JeffOlsen-SLAC/LG_Pizza_BPM/doc/rsttiming.jpg

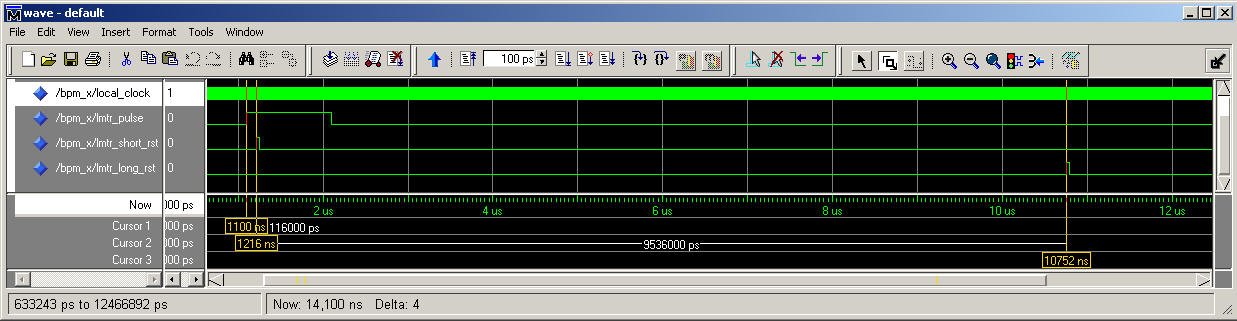
doc/rsttiming.jpg
