JeffOlsen-SLAC/LG_Pizza_BPM/doc/TTLTrig.pdf

## LCLS Digital BPM

Converting the BPM Trigger input from NIM to TTL.

1. Remove transformer T2
2. Jumper pin 6 to 1

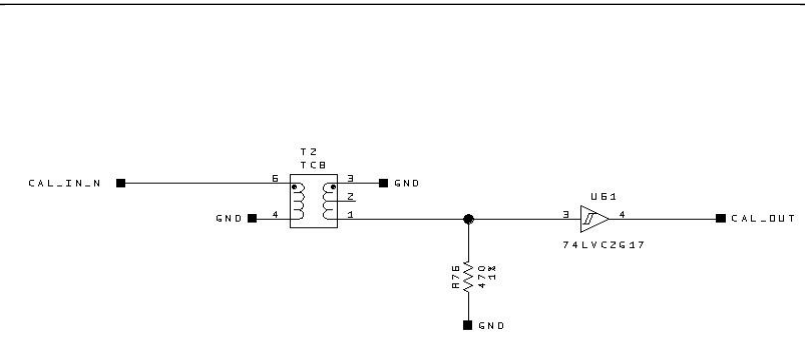
[picture p4: figure]
