JeffOlsen-SLAC/LG_Pizza_BPM/doc/panel1.jpg

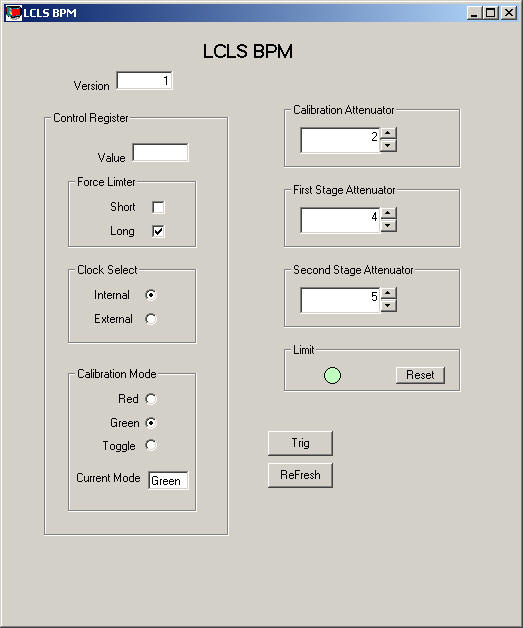
doc/panel1.jpg
