JeffOlsen-SLAC/LG_Pizza_BPM/doc/TTLTrig.jpg

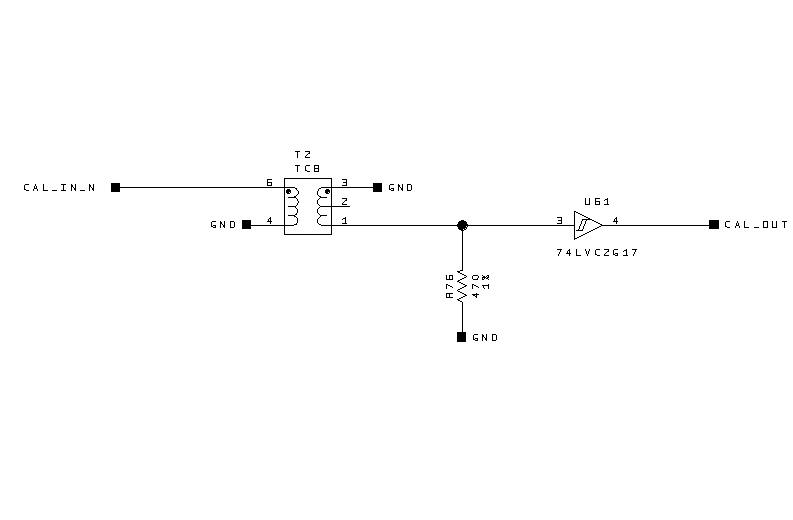
doc/TTLTrig.jpg
