JeffOlsen-SLAC/LG_Pizza_BPM/doc/bpm_digital.xls

# | QTY | REFDES | PART NUMBER | DESCRIPTION
1 | 1 | U6 |  | 74LVC2G17DBVR; PHILLIPS DUAL NON-INVERTING SCHMITT-TRIGGER
2 | 1 | $1I274\$1I151 |  | 2380-5121TG; 3M RIGHT ANGLE HEADER|92F1470; NEWARK PART NUMBER|ONLY 6 PINS USED
3 | 1 | $1I292 |  | 2520-6002UB; 20 PIN HEADER
4 | 1 | $1I46 |  | 5745781-2; AMP DB9 PCB RIGHT ANGLE MOUNT CONNECTOR|42K8778 NEWARK PART NUMBER
5 | 1 | C7 |  | C0805C102K5RAC; KEMET 0.001UF, 0805 CAPACITOR
6 | 4 | $1I38-41 |  | C0805C104K5RAC; KEMET 0.1UF, 0805 CAPACITOR
7 | 20 | C89-108 |  | C0805C104K5RAC; KEMET 0.1UF, 0805 CAPACITOR
8 | 1 | $1I315 |  | CTS; CB3LV-3C-60.0000-T. 60 MHZ OSCILLATOR. 3.3V SMD|CTX285LVCT-ND DIGI-KEY PART
9 | 2 | U4-5 |  | MAX701CSA; MAXIM POWER SUP.
10 | 1 | $1I42 |  | MAX3232ECWE; MAX RS232 TRANSCEIVER
11 | 1 | TP1 |  | MOUSER 151-201 WHITE TEST POINT
12 | 2 | U10,U16 |  | NC7S32M5X; FAIRCHILD 2 INPUT OR GATE
13 | 1 | U7 |  | NC7SZ74K8X; FAIRCHILD TINYLOGIC UHS D FLIP-FLOP
14 | 1 | R15 |  | RK73H2AT51R1; KOA 51.1 OHM 1% 100MW RESISTOR
15 | 2 | R23-24 |  | RK73H2AT68R1F; KOA 68.1 OHM 1% 100MW RESISTOR
16 | 7 | R6-12 |  | RK73H2AT1001F; KOA 1.00K OHM 100MW RESISTOR
17 | 1 | R5 |  | RK73H2AT3010F; KOA 301 OHM 100MW RESISTOR
18 | 1 | R28 |  | RK73H2AT4020F; KOA 402 OHM 1% 100MW RESISTOR
19 | 1 | R27 |  | RK73H2AT4700F; KOA 470 OHM 1% 100MW RESISTOR
20 | 2 | R13-14 |  | RK73H2AT4751F; KOA 4.75K OHM 1% RESISTOR. SM0805
21 | 1 | R22 |  | RK73H2AT6040F; KOA 604 OHM 1% 100MW RESISTOR
22 | 2 | $1I317-318 |  | SMA
23 | 4 | $1I51,$1I108,$1I111,$1I194 |  | SN74ALVC16T245DGG; 16-BIT BIDIRECTIONAL LEVEL TRANSCEIVER
24 | 1 | T2 |  | TC-8; MINI-CIRCUITS RF TRANSFORMER
25 | 1 | U3 |  | XC3S200-5PQ208C; XILINX SPARTAN 3 FPGA
26 | 1 | $1I274\$1I9 |  | XC3S400-5PQ208C; XILINX SPARTAN 3 FPGA
27 | 2 | U8-9 |  | XCF02SVO20C; XILINX PLATFORM FLASH PROM
