JeffOlsen-SLAC/LG_Pizza_BPM/(list of files, cad)

Other CAD files:
xilinx/bpm_x_V3x/work/bpm/_vhdl.psm
