JeffOlsen-SLAC/LG_Pizza_BPM/doc/digital_bpm.pdf

A

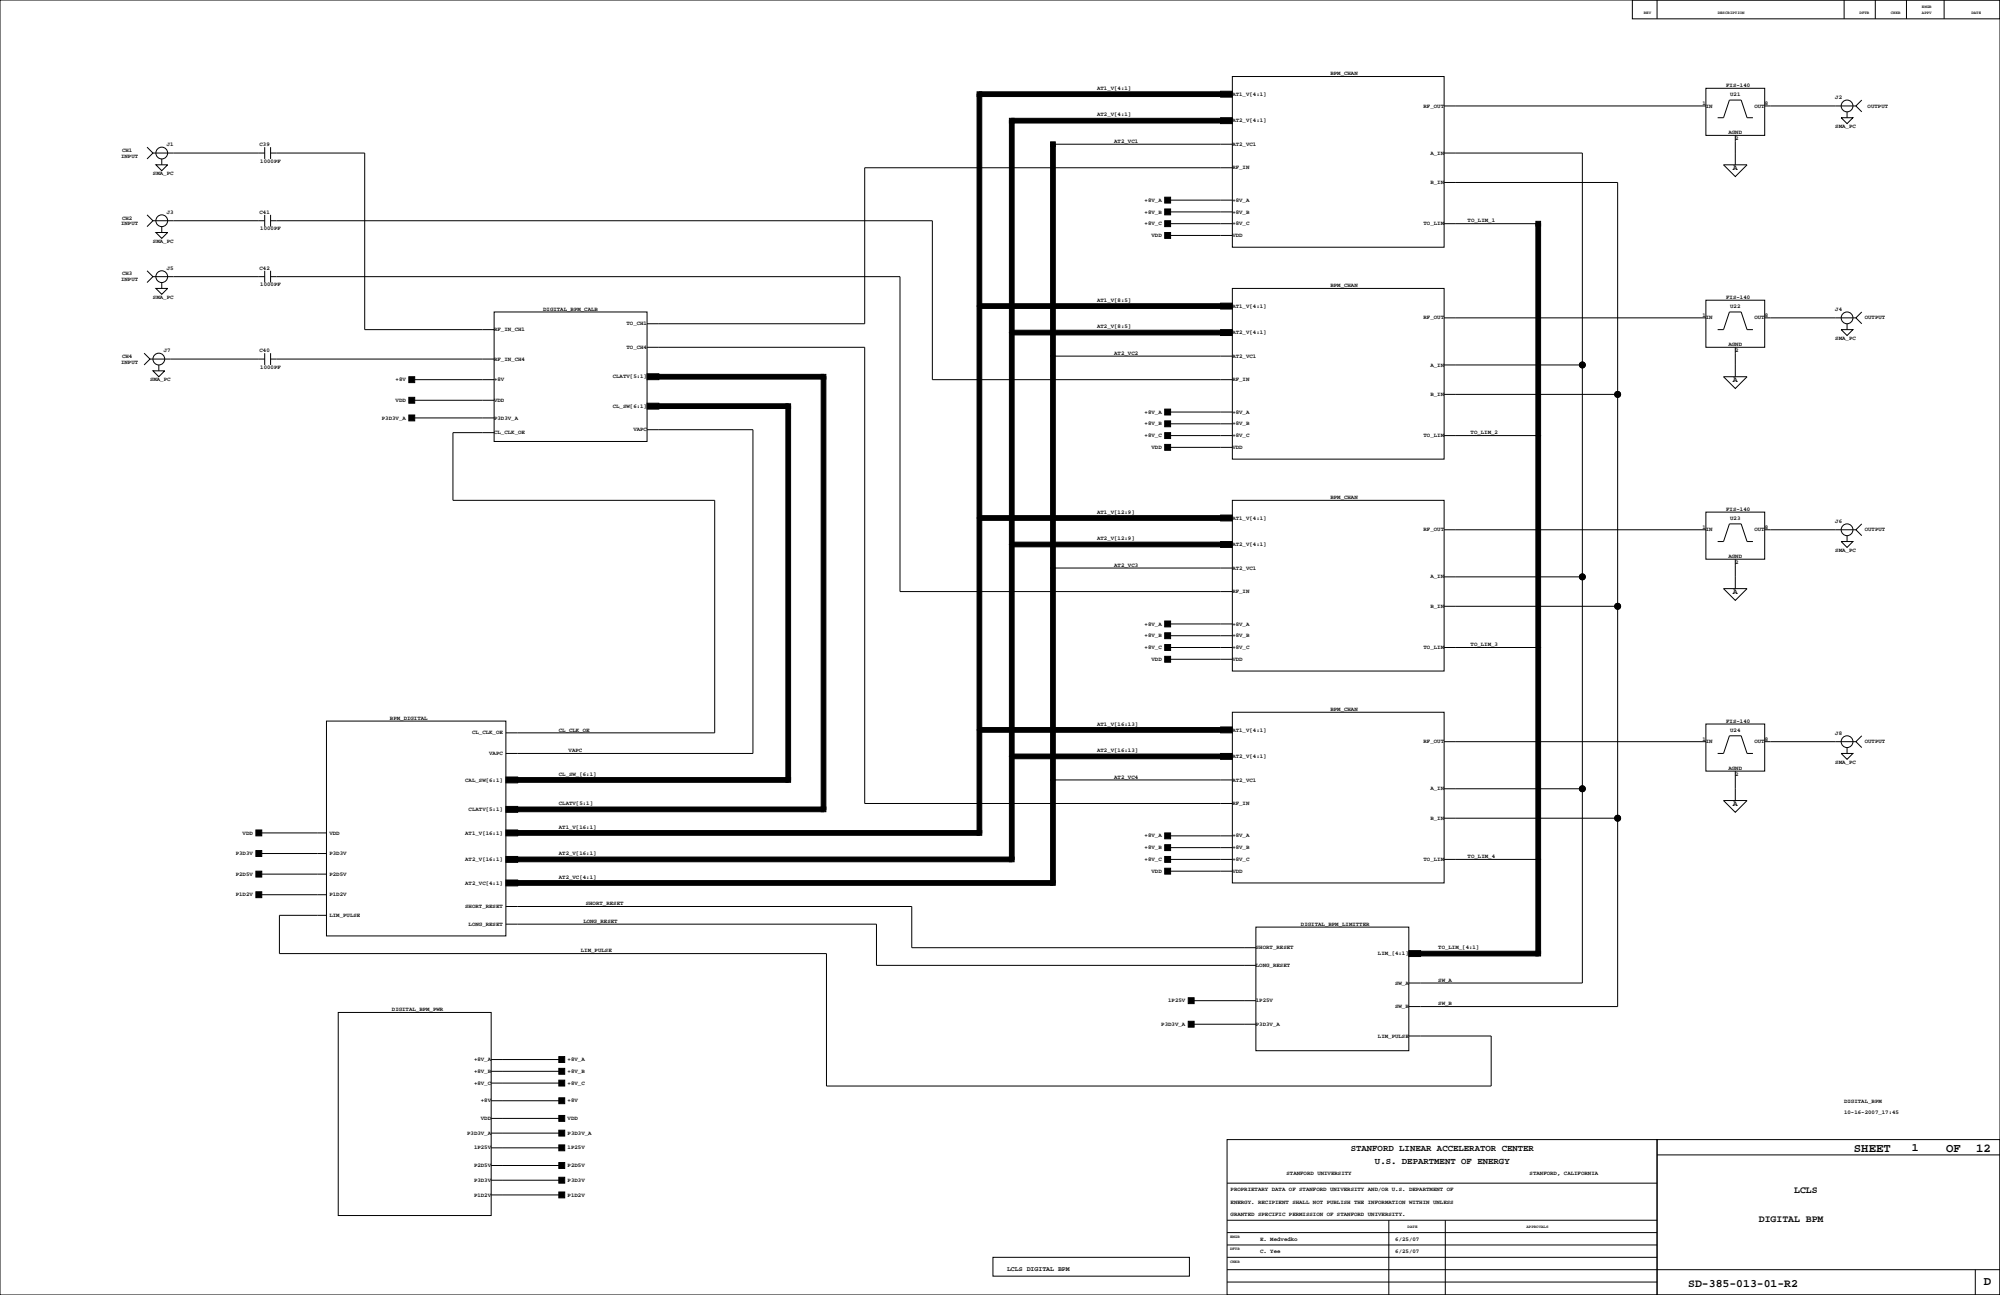
[picture p7: page 1]

STANFORD LINEAR ACCELERATOR CENTER
U.S. DEPARTMENT OF ENERGY

PROPRIETARY DATA OF STANFORD UNIVERSITY AND/OR U.S. DEPARTMENT OF

ENERGY. RECIPIENT SHALL NOT PUBLISH THE INFORMATION WITHIN UNLESS

GRANTED SPECIFIC PERMISSION OF STANFORD UNIVERSITY.

A
A

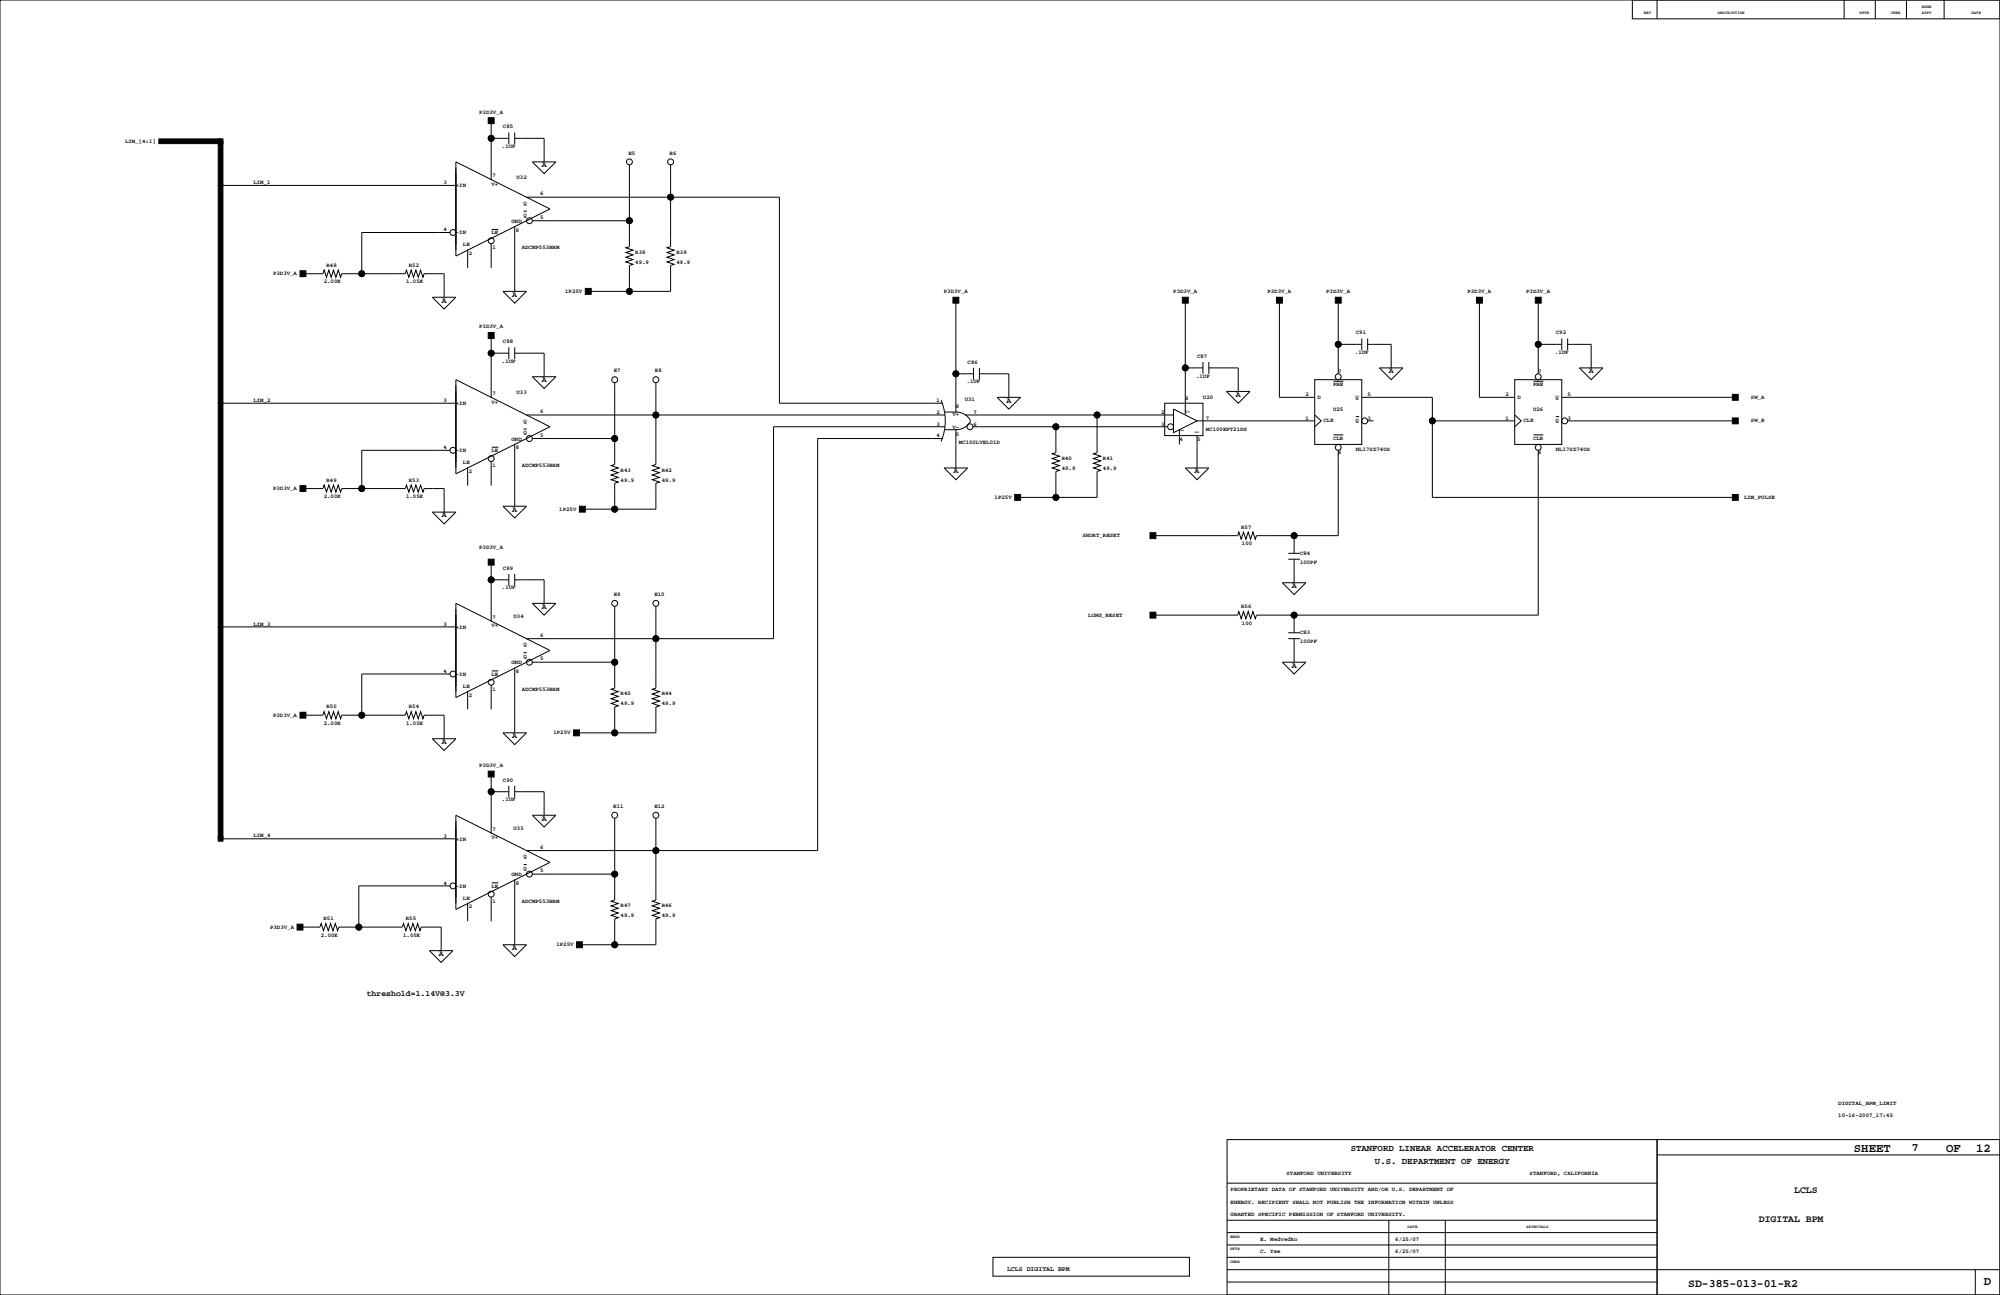
[picture p8: page 2]

STANFORD LINEAR ACCELERATOR CENTER
U.S. DEPARTMENT OF ENERGY

A

A

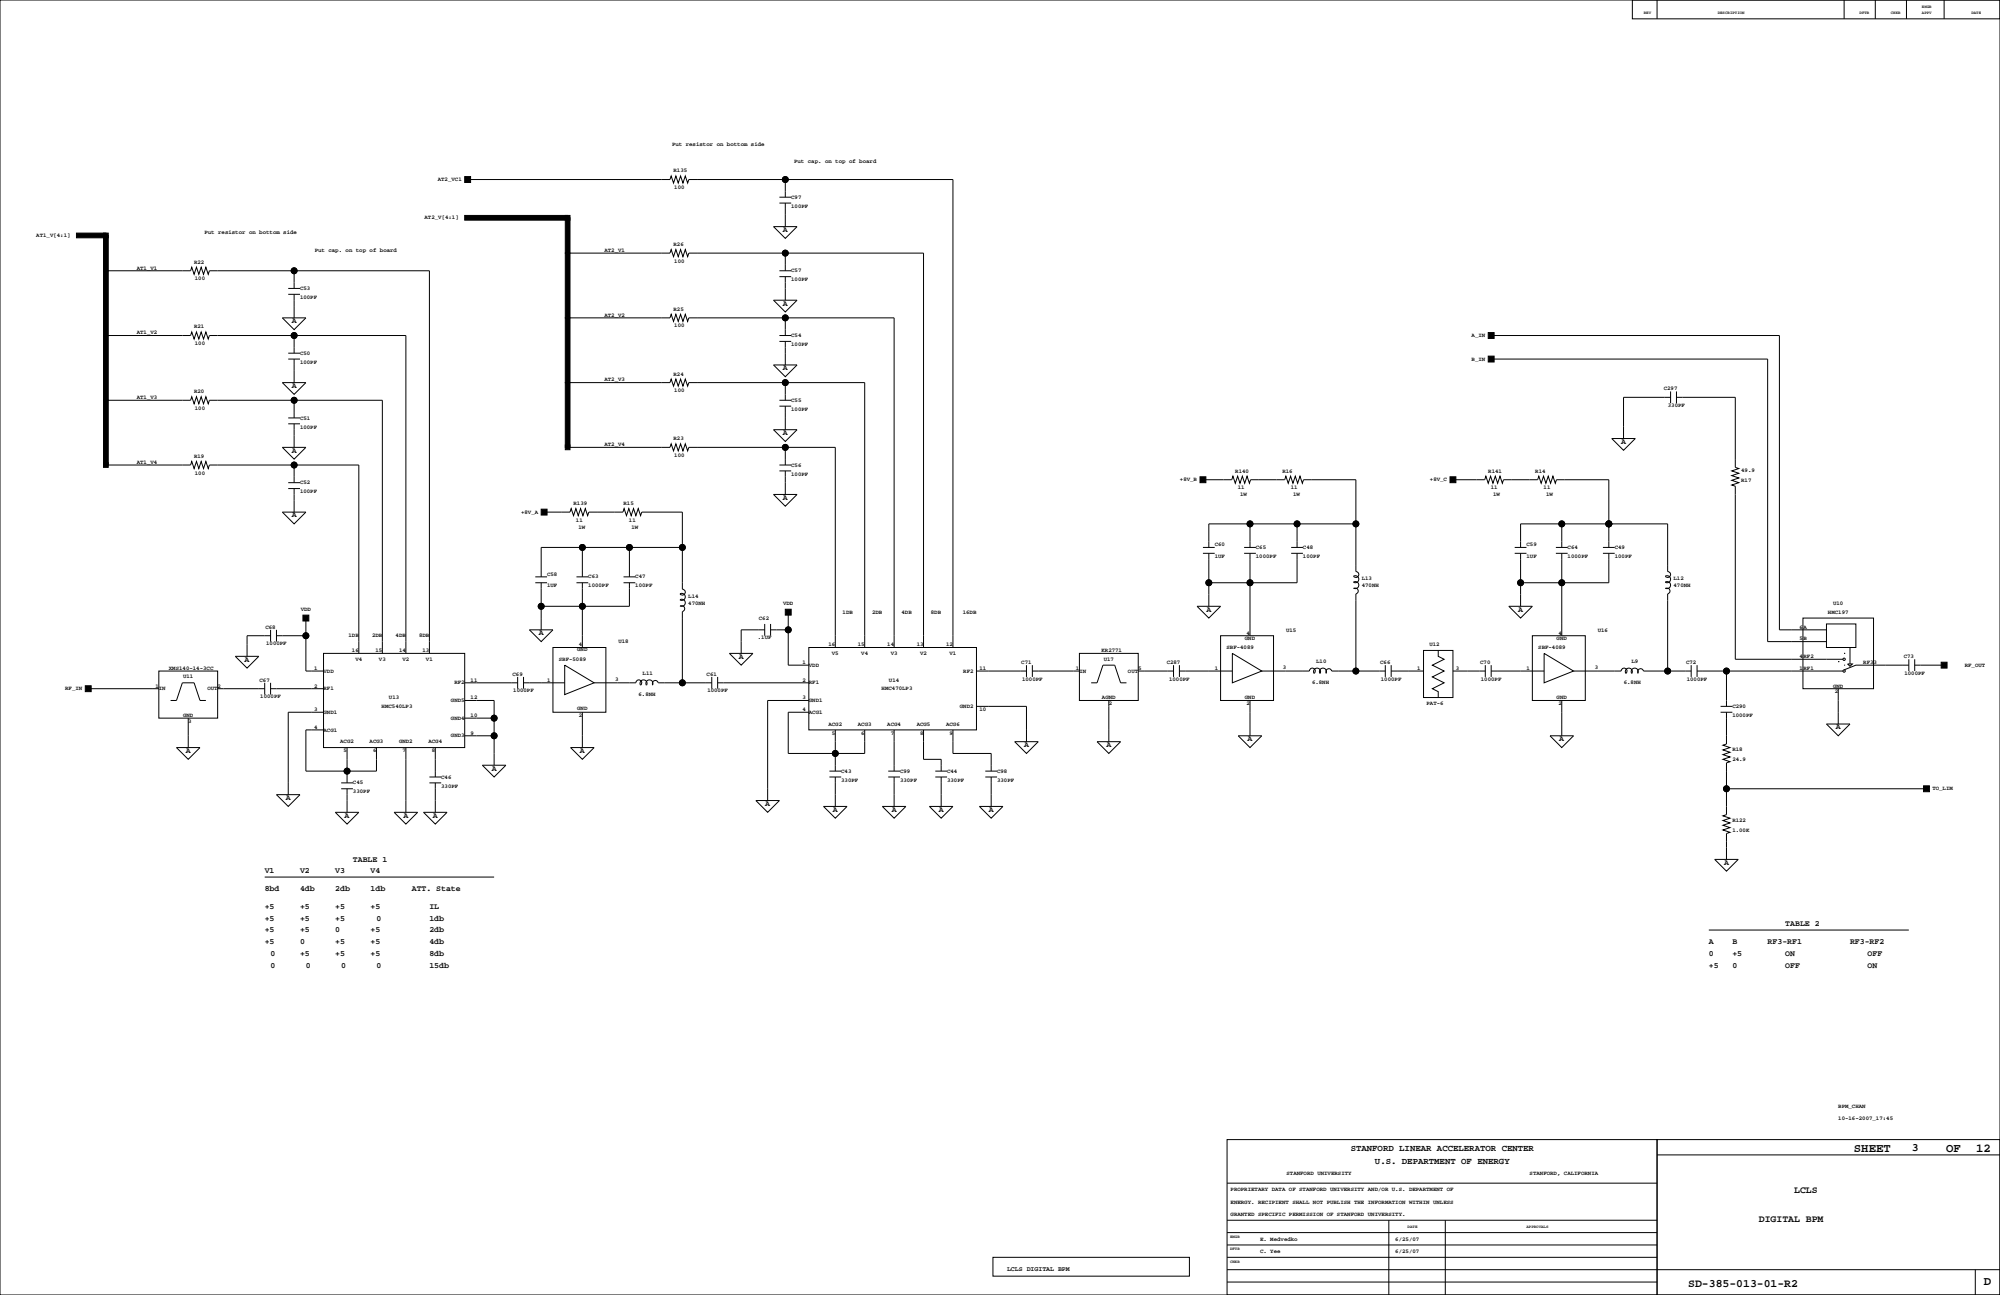
[picture p9: page 3]

Put resistor on bottom side

Put cap. on top of board

STANFORD LINEAR ACCELERATOR CENTER
U.S. DEPARTMENT OF ENERGY

A

A

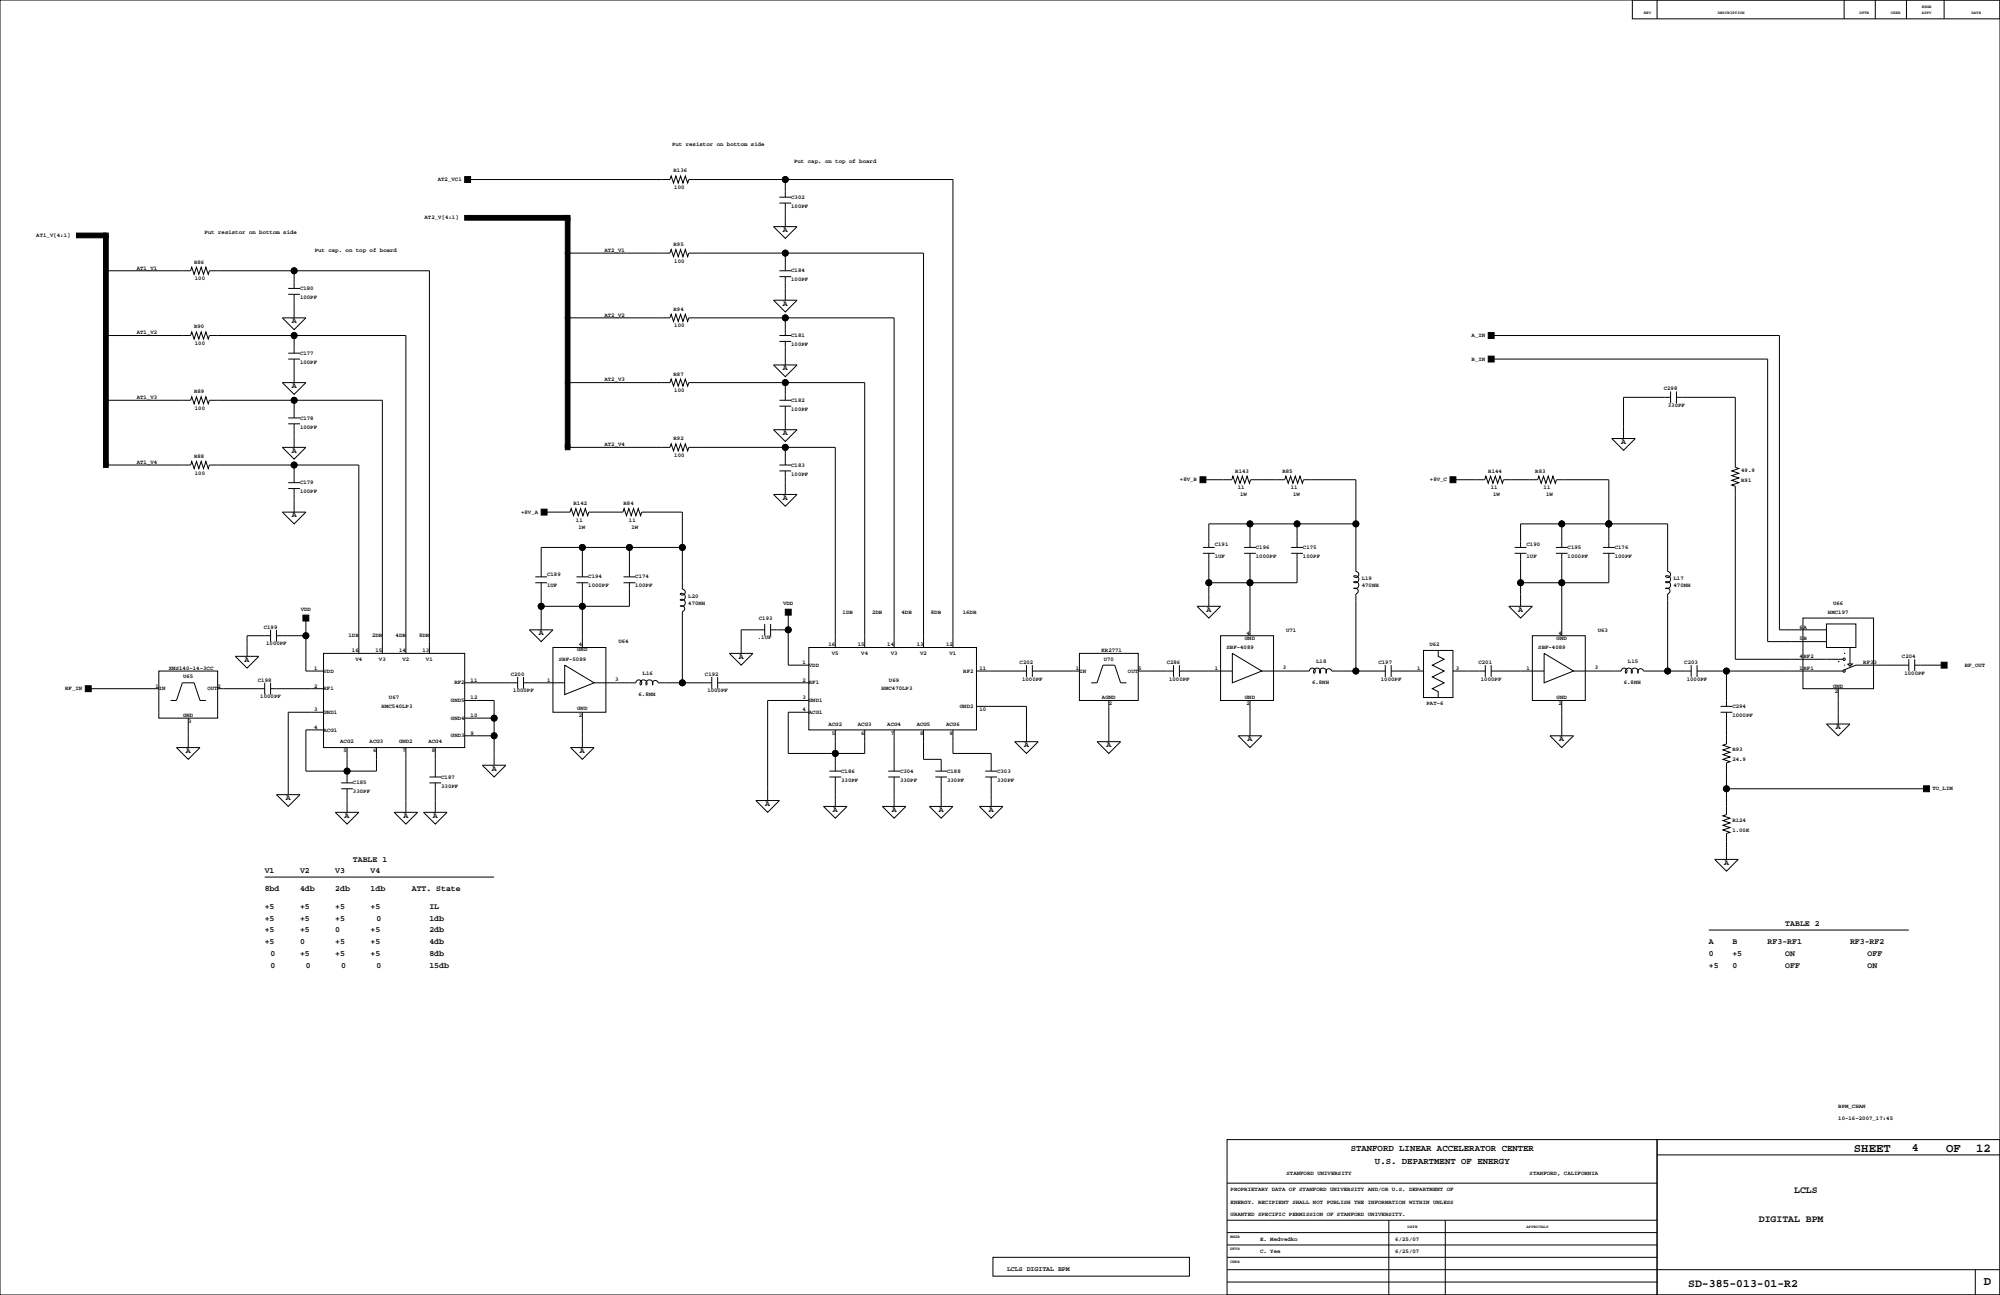
[picture p10: page 4]

Put resistor on bottom side

Put cap. on top of board

STANFORD LINEAR ACCELERATOR CENTER
U.S. DEPARTMENT OF ENERGY

A

A

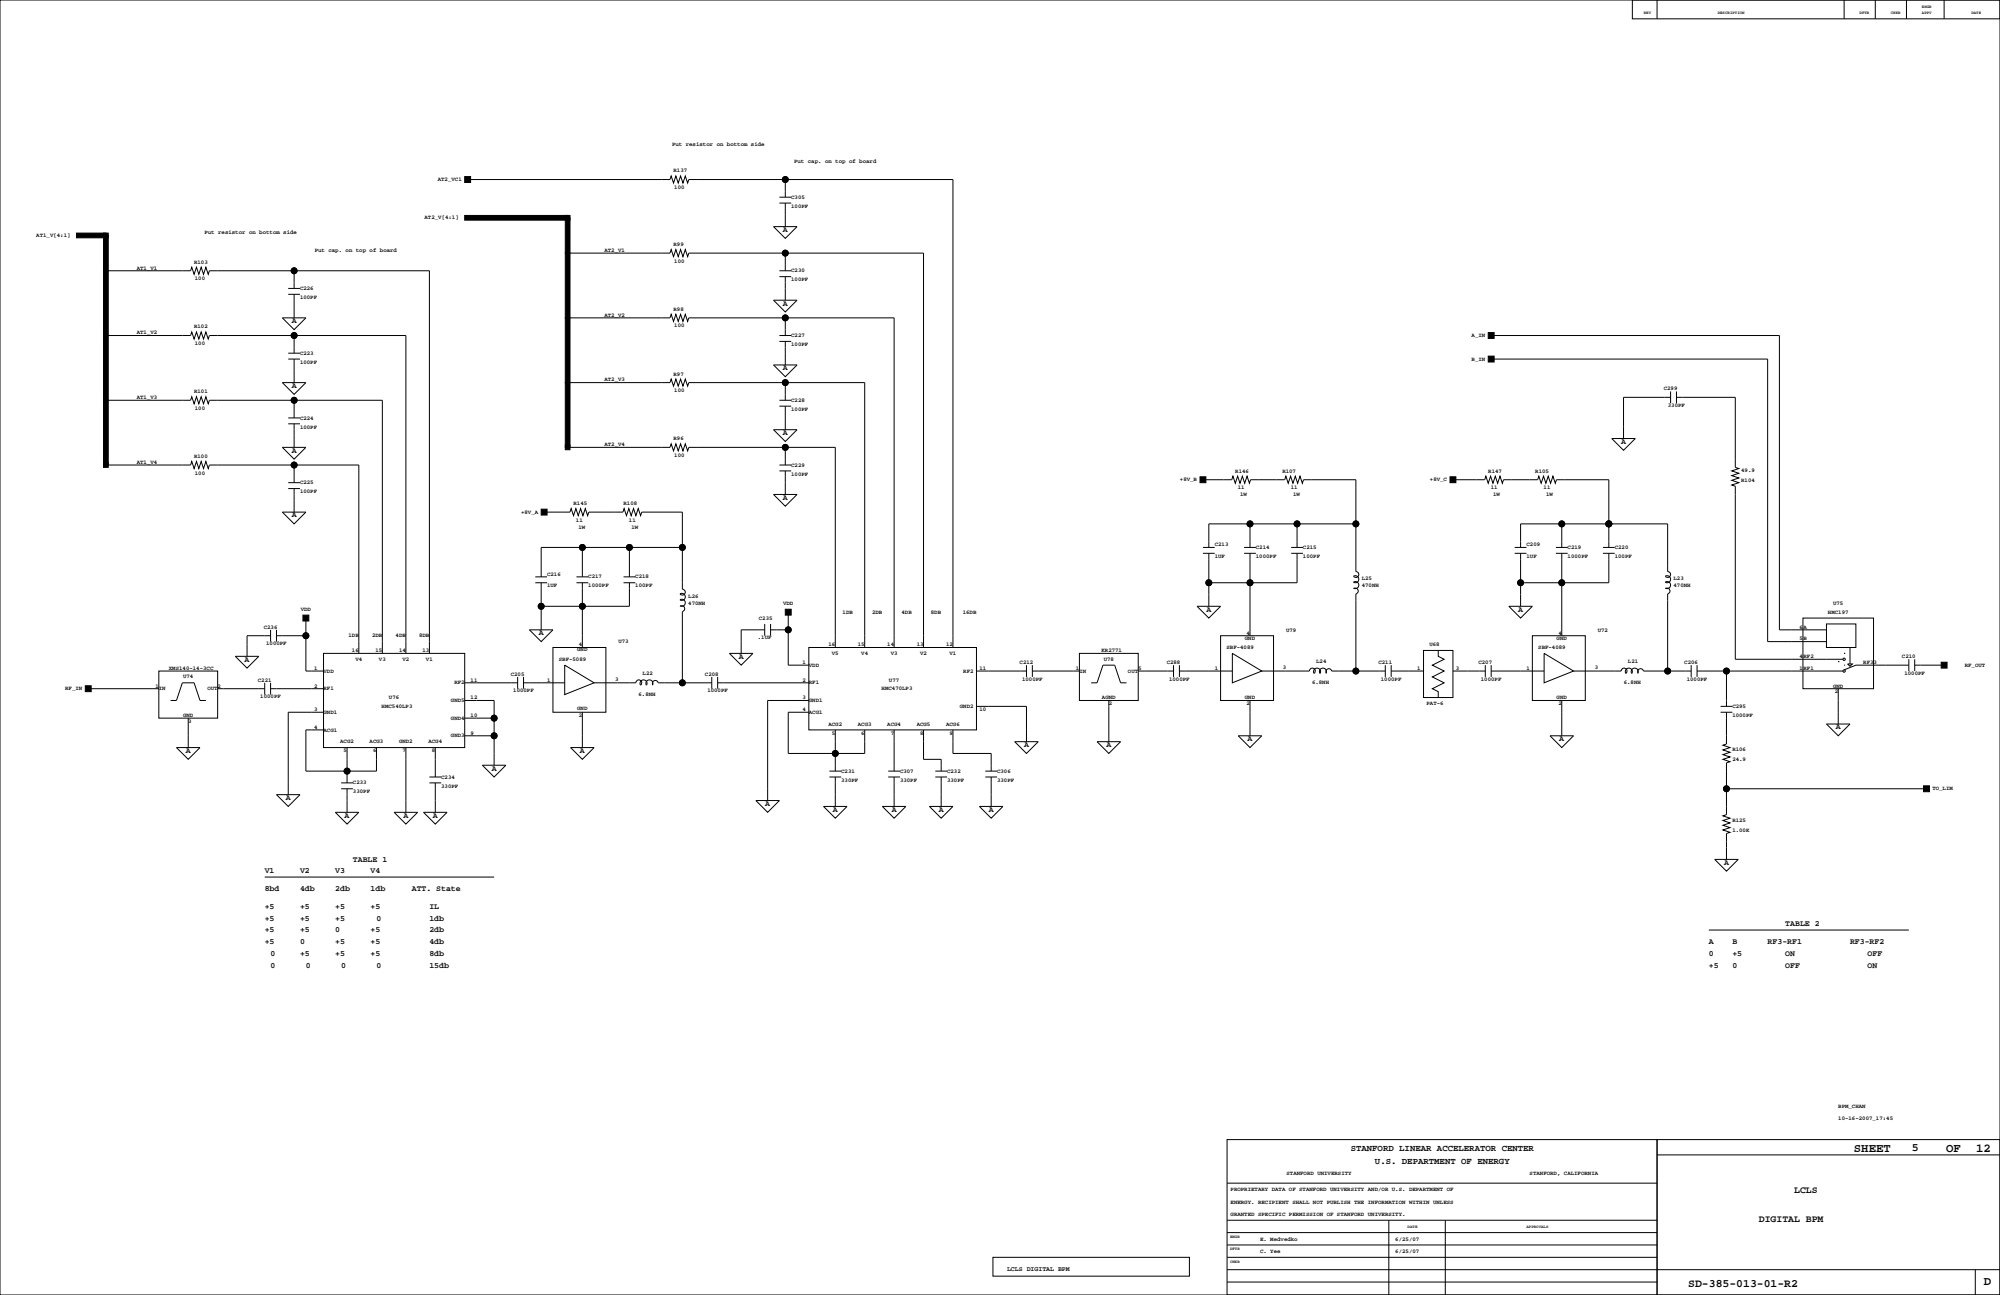
[picture p11: page 5]

Put resistor on bottom side

Put cap. on top of board

STANFORD LINEAR ACCELERATOR CENTER
U.S. DEPARTMENT OF ENERGY

A

A

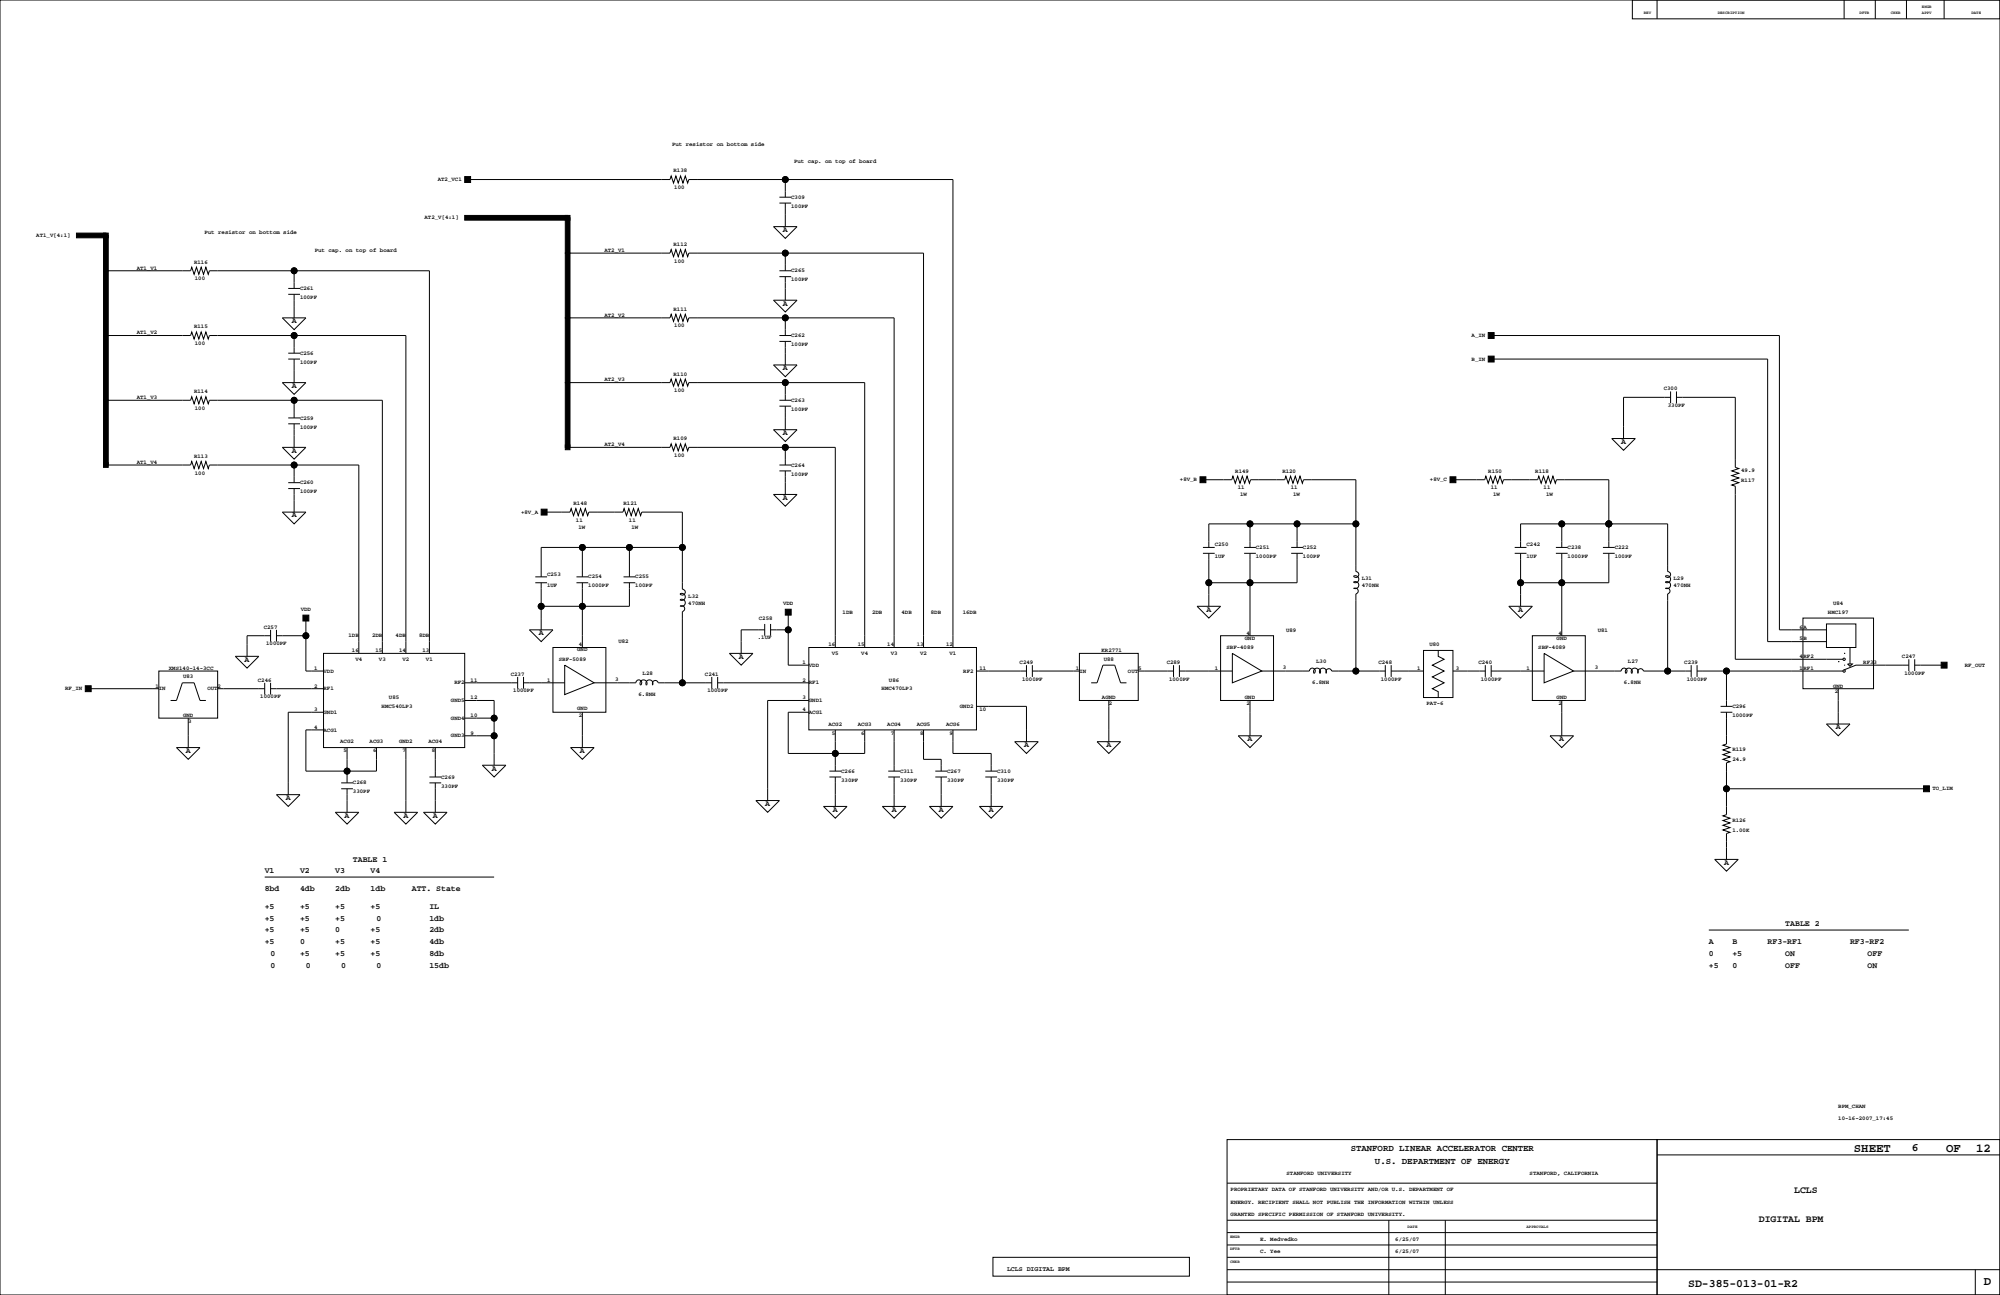
[picture p12: page 6]

Put resistor on bottom side

Put cap. on top of board

STANFORD LINEAR ACCELERATOR CENTER
U.S. DEPARTMENT OF ENERGY

A

A

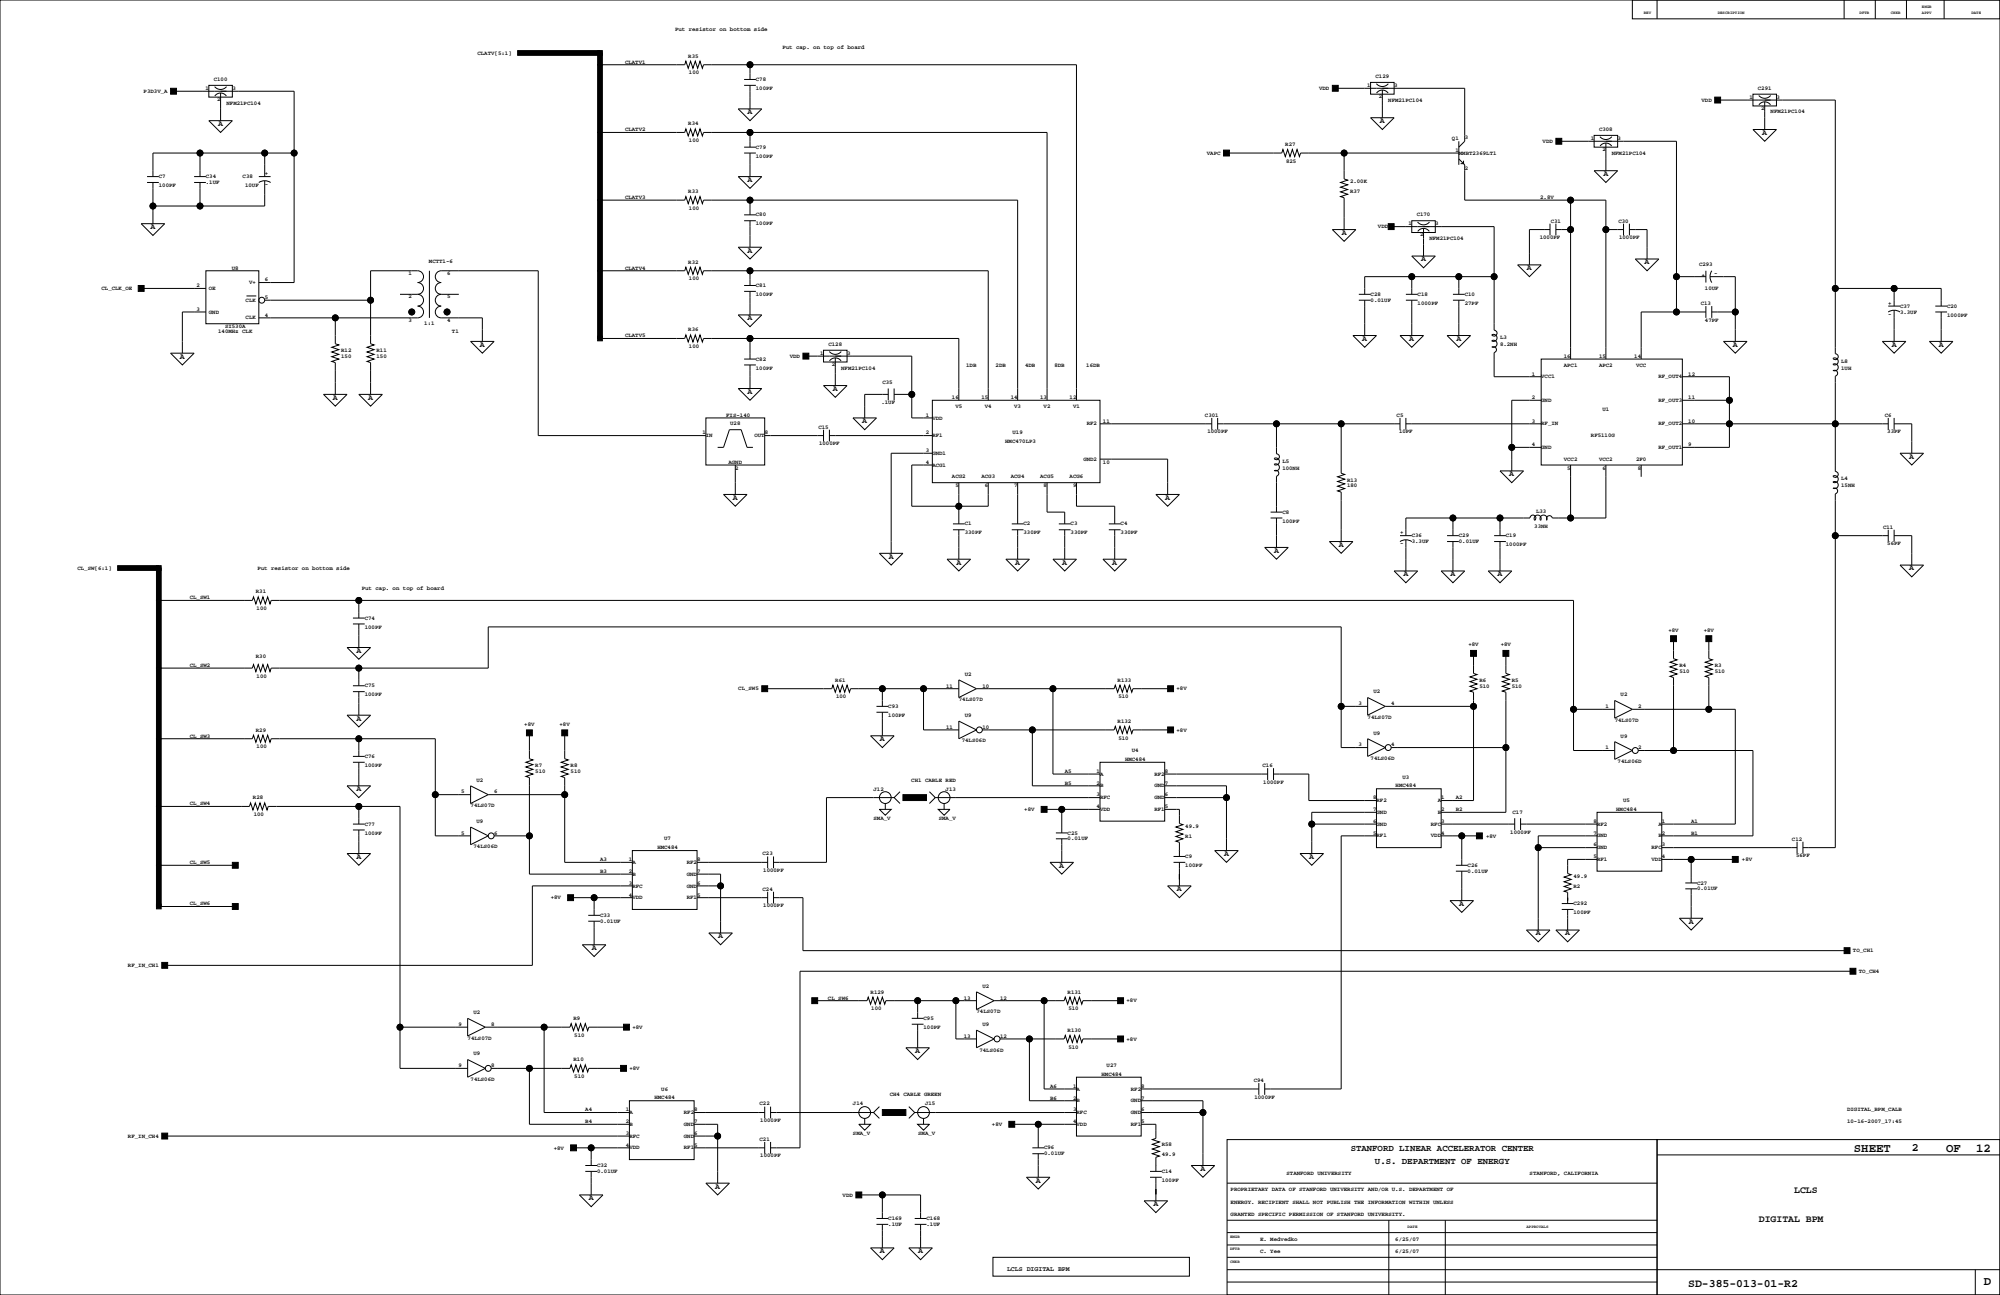
[picture p13: page 7]

Put resistor on bottom side

Put cap. on top of board

STANFORD LINEAR ACCELERATOR CENTER
U.S. DEPARTMENT OF ENERGY

A

A

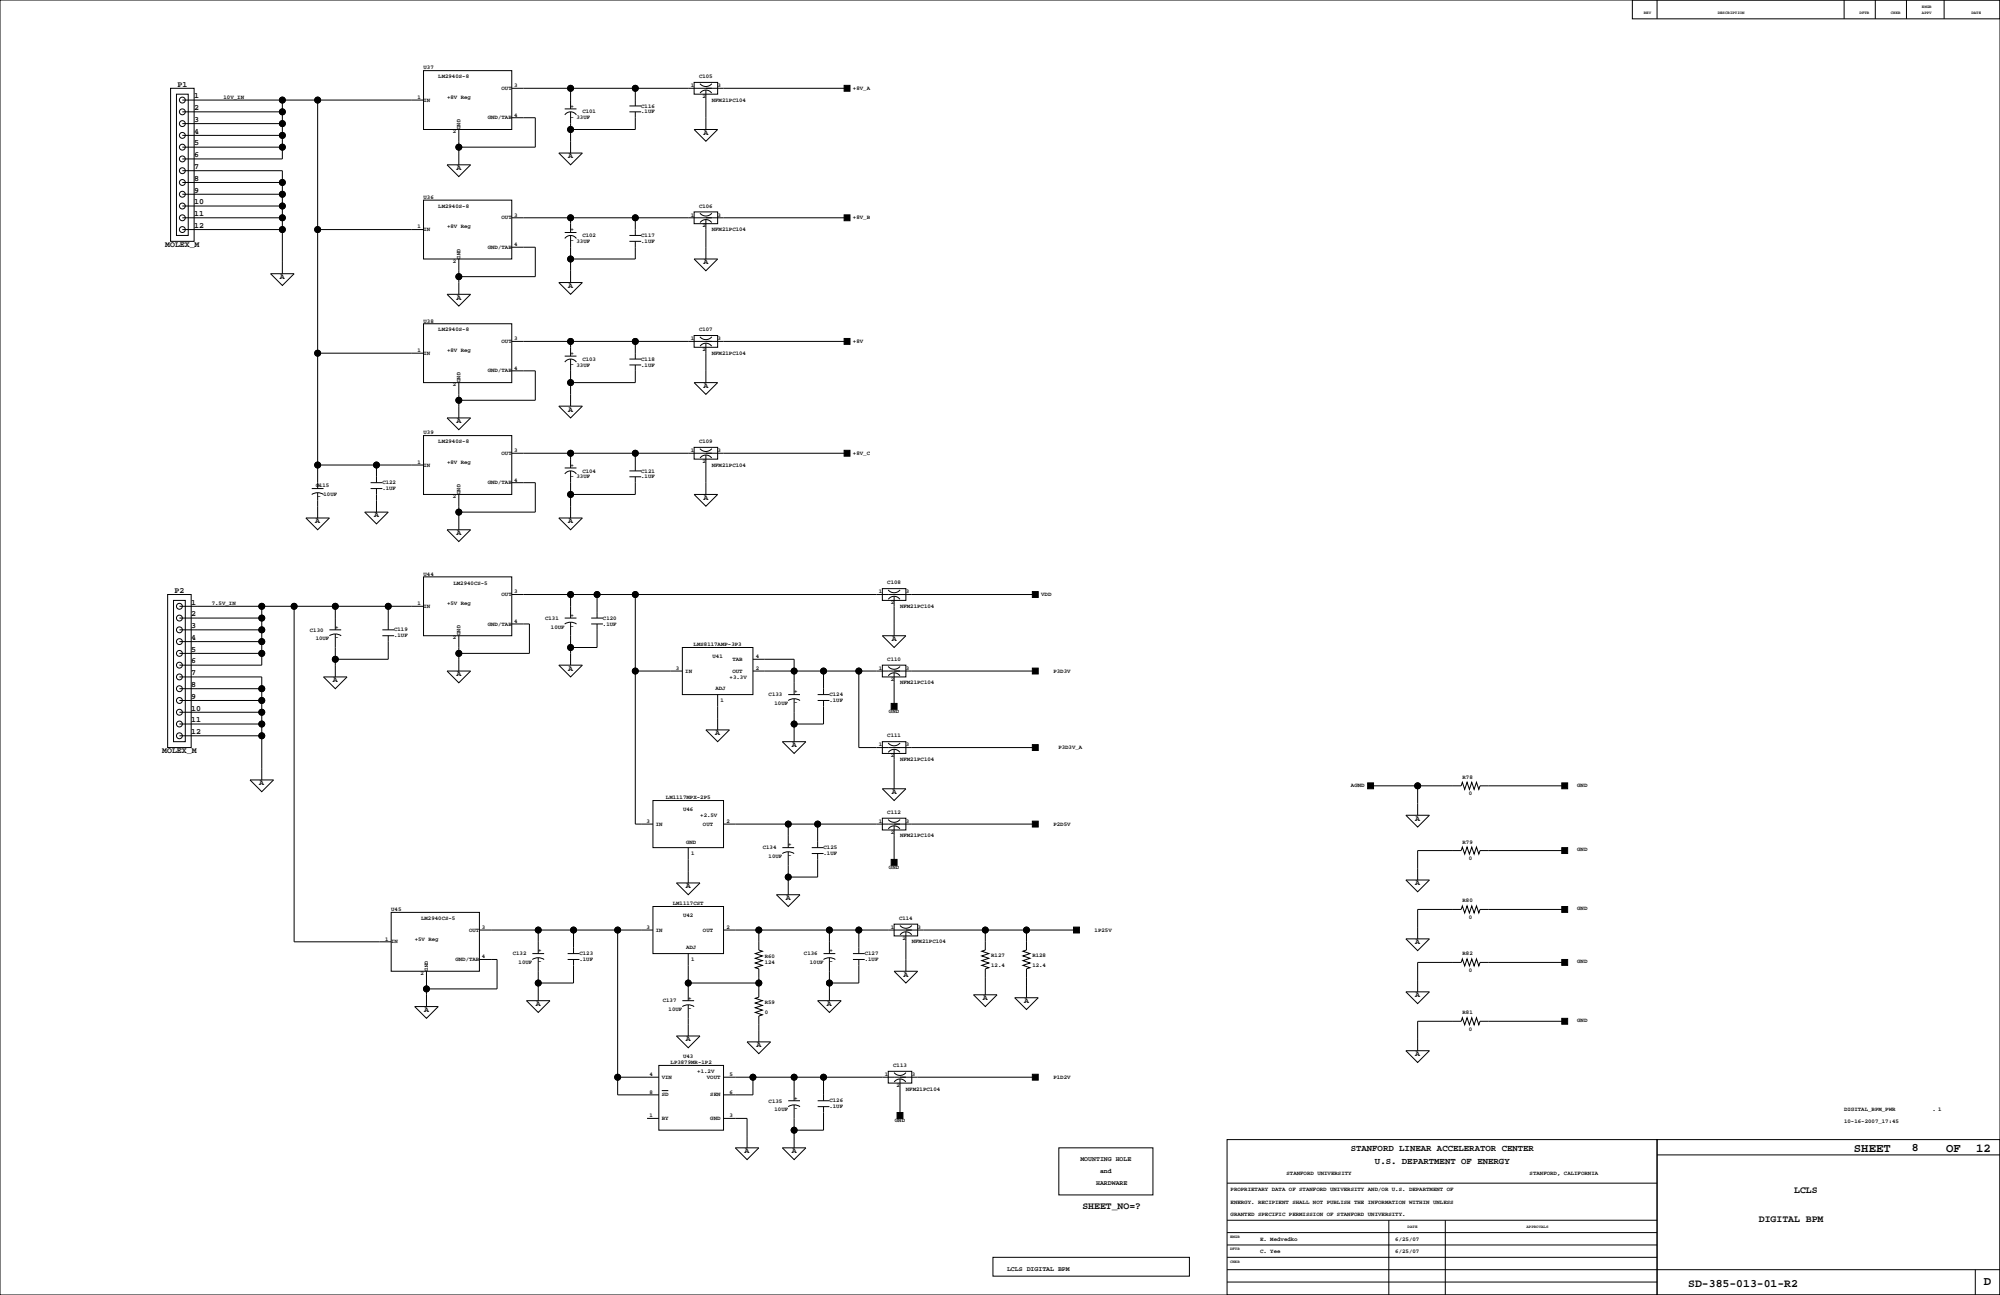
[picture p14: page 8]

STANFORD LINEAR ACCELERATOR CENTER
U.S. DEPARTMENT OF ENERGY

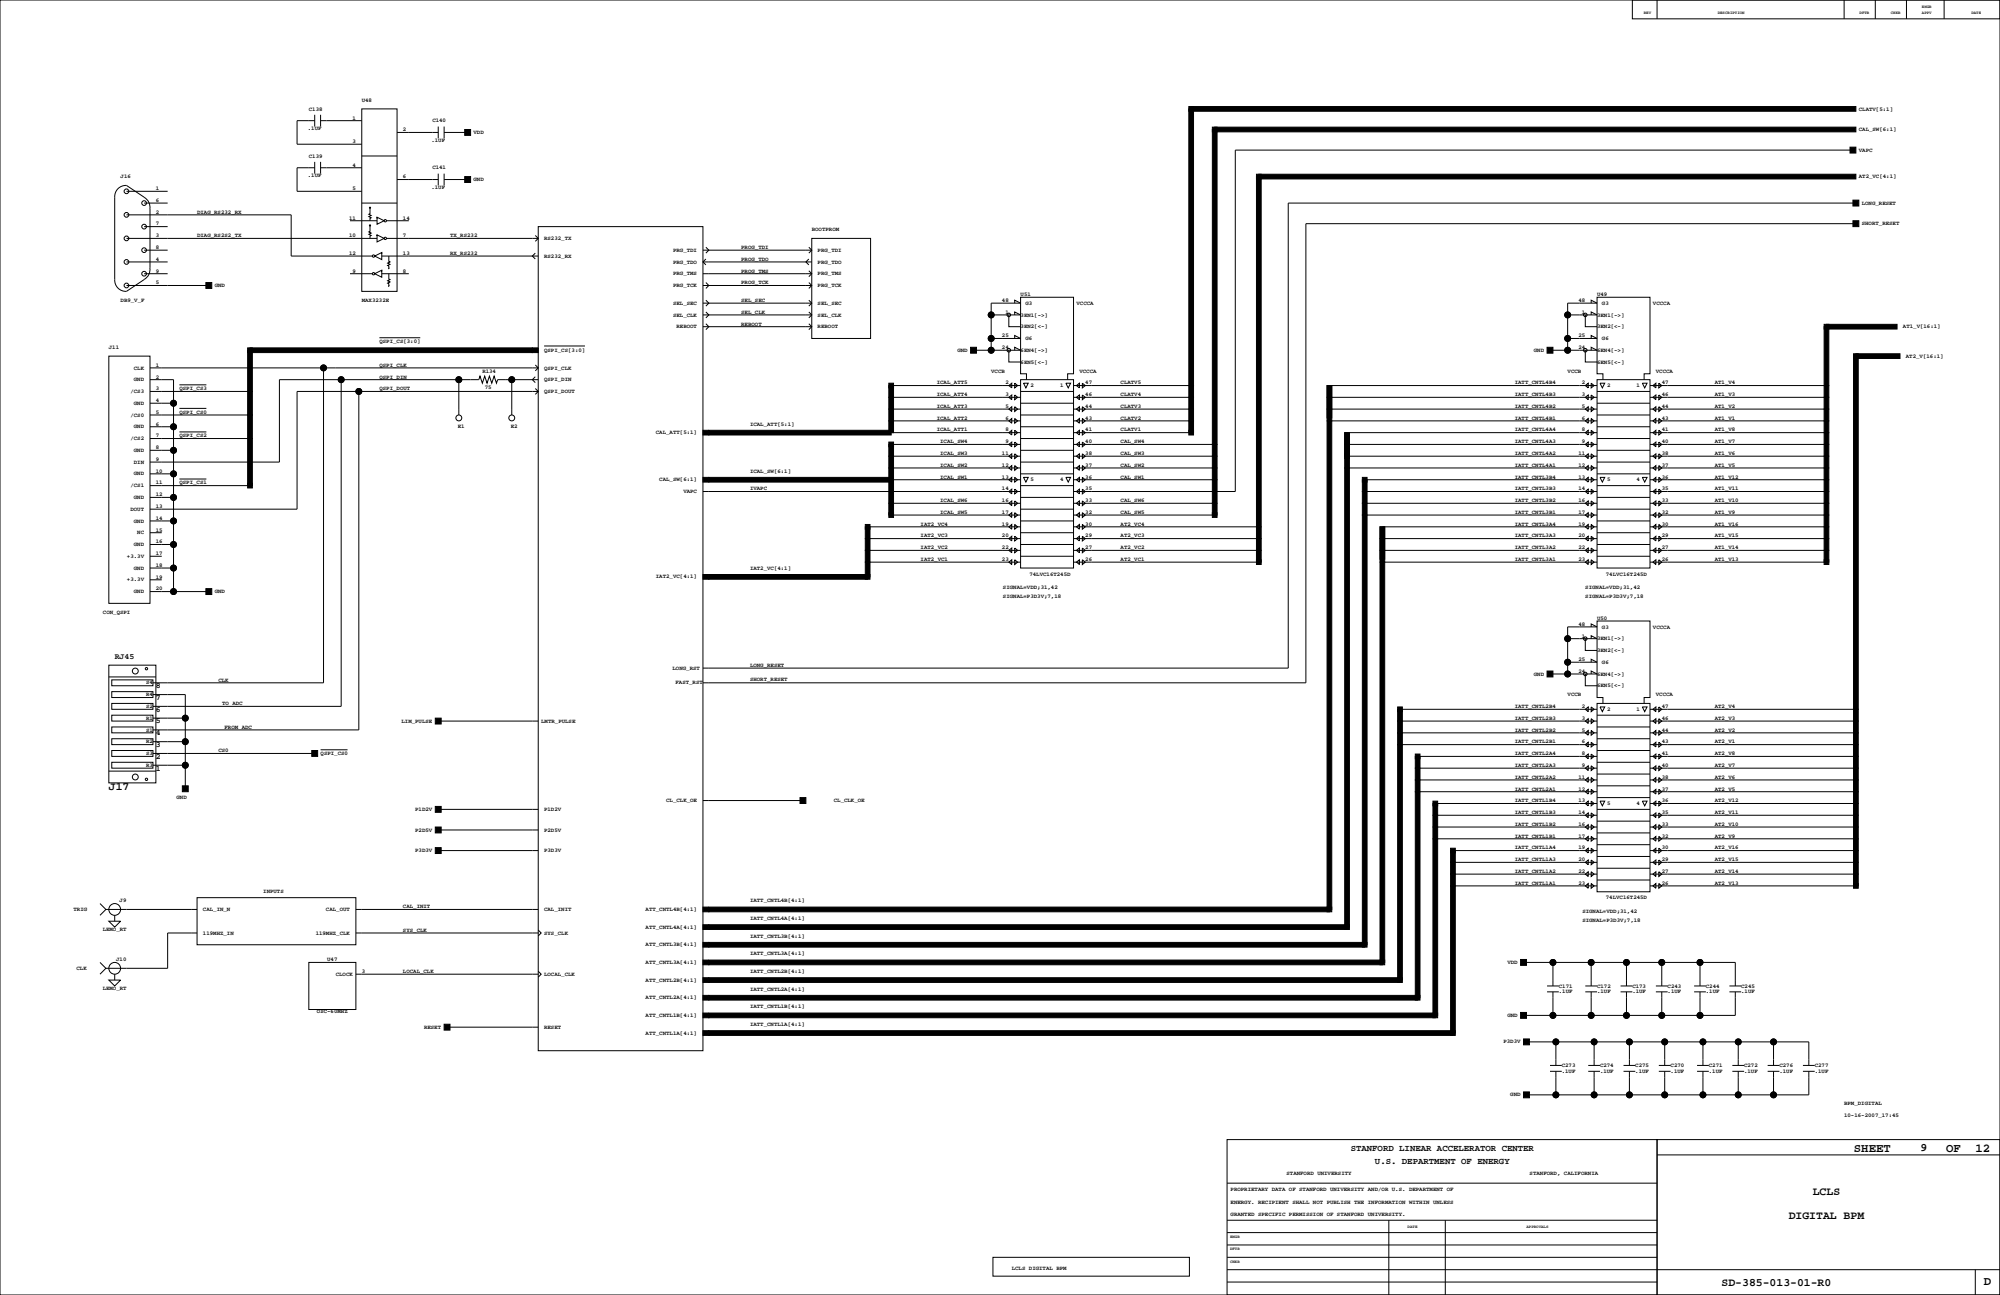
[picture p15: page 9]

STANFORD LINEAR ACCELERATOR CENTER
U.S. DEPARTMENT OF ENERGY

# MOUNTING HOLES and HARDWARE

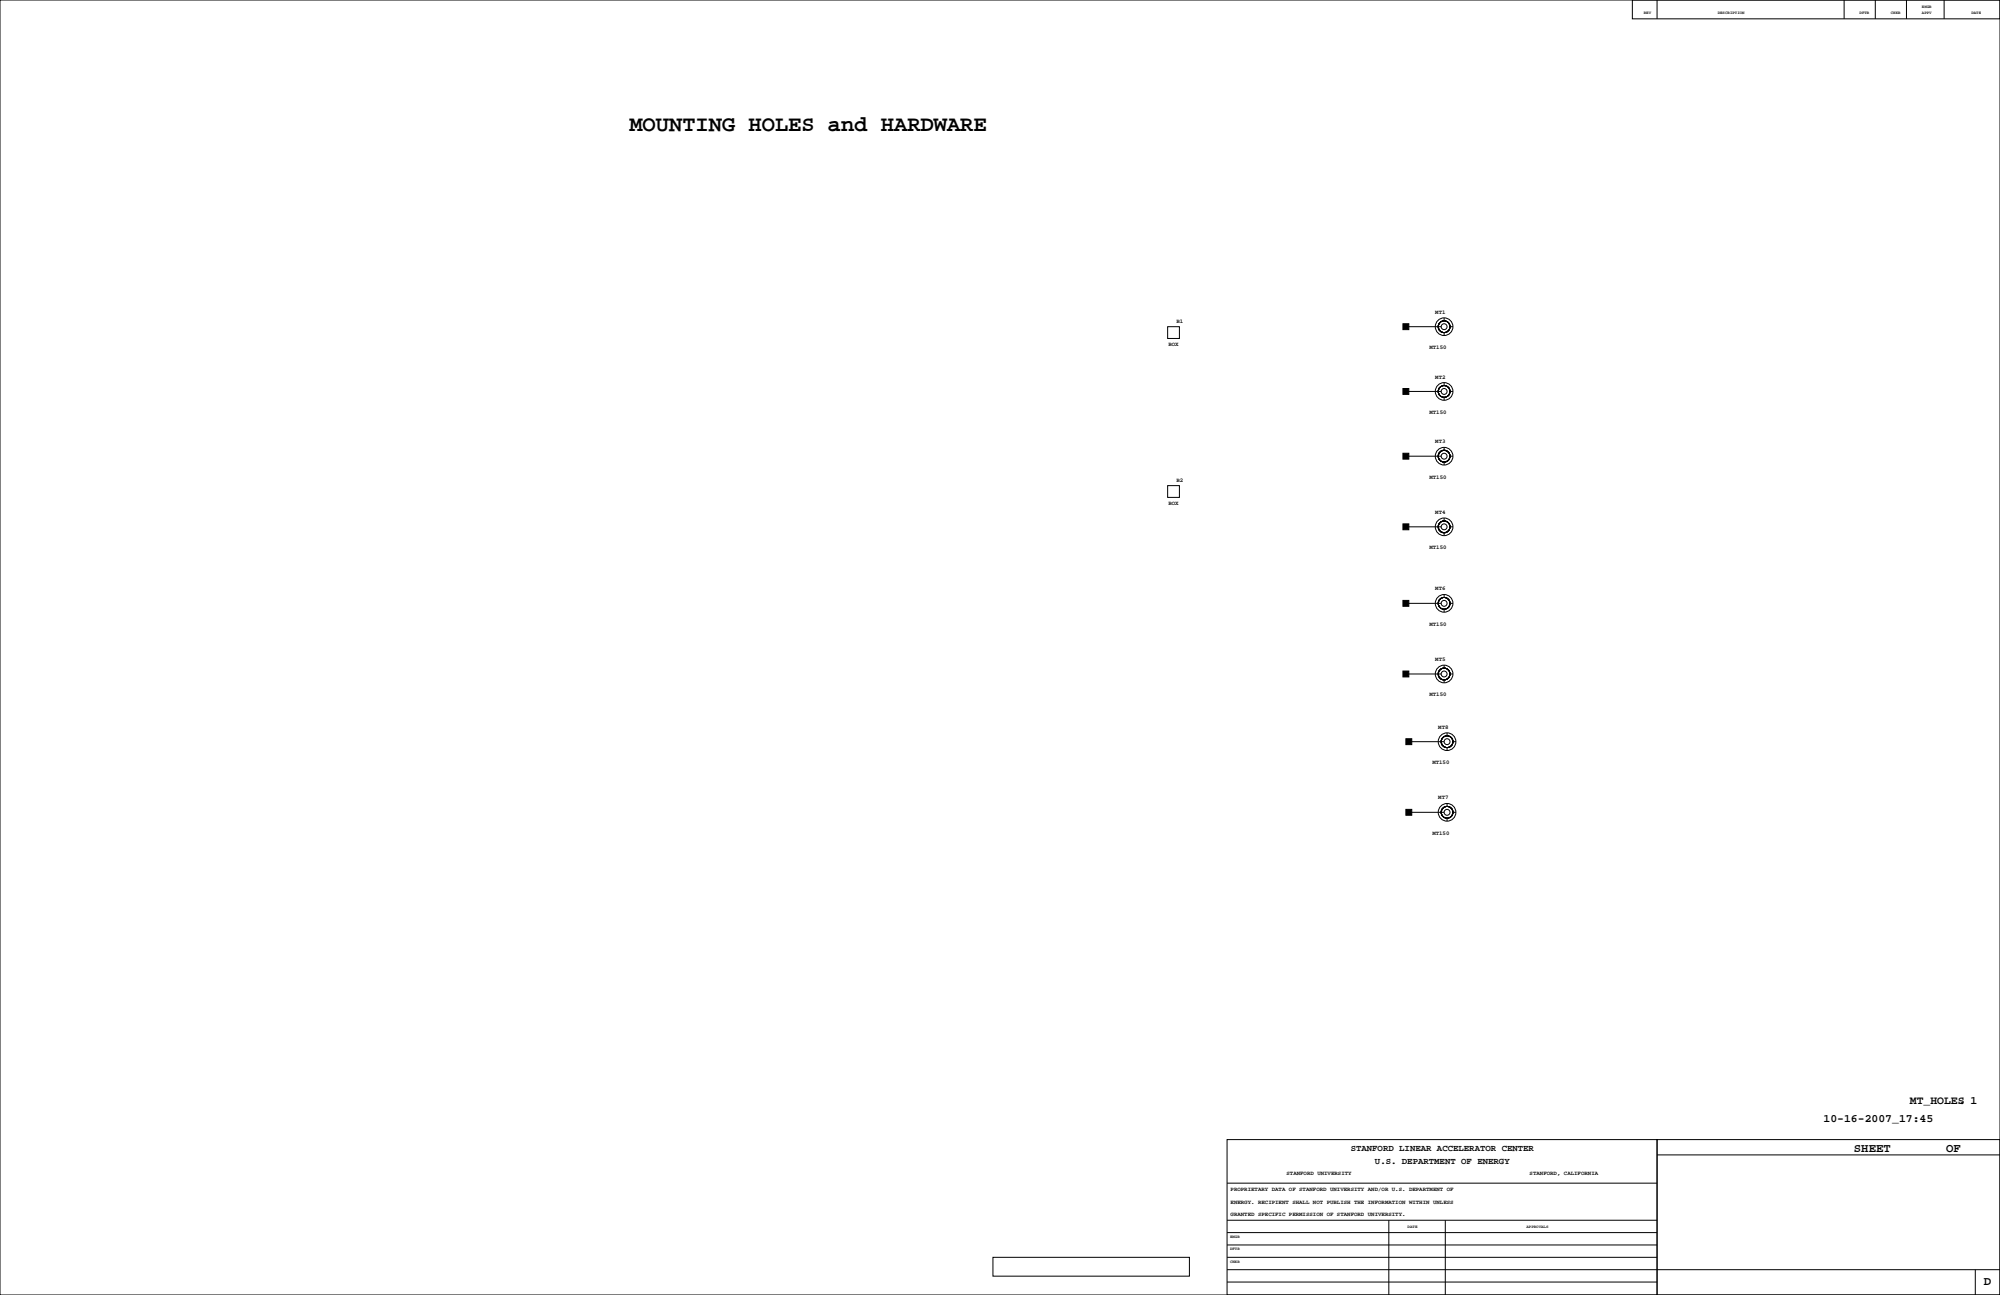
[picture p16: page 10]
SHEET; STANFORD UNIVERSITY; STANFORD, CALIFORNIA; BOX; MT_HOLES 10-16-2007_17:45

STANFORD LINEAR ACCELERATOR CENTER
U.S. DEPARTMENT OF ENERGY

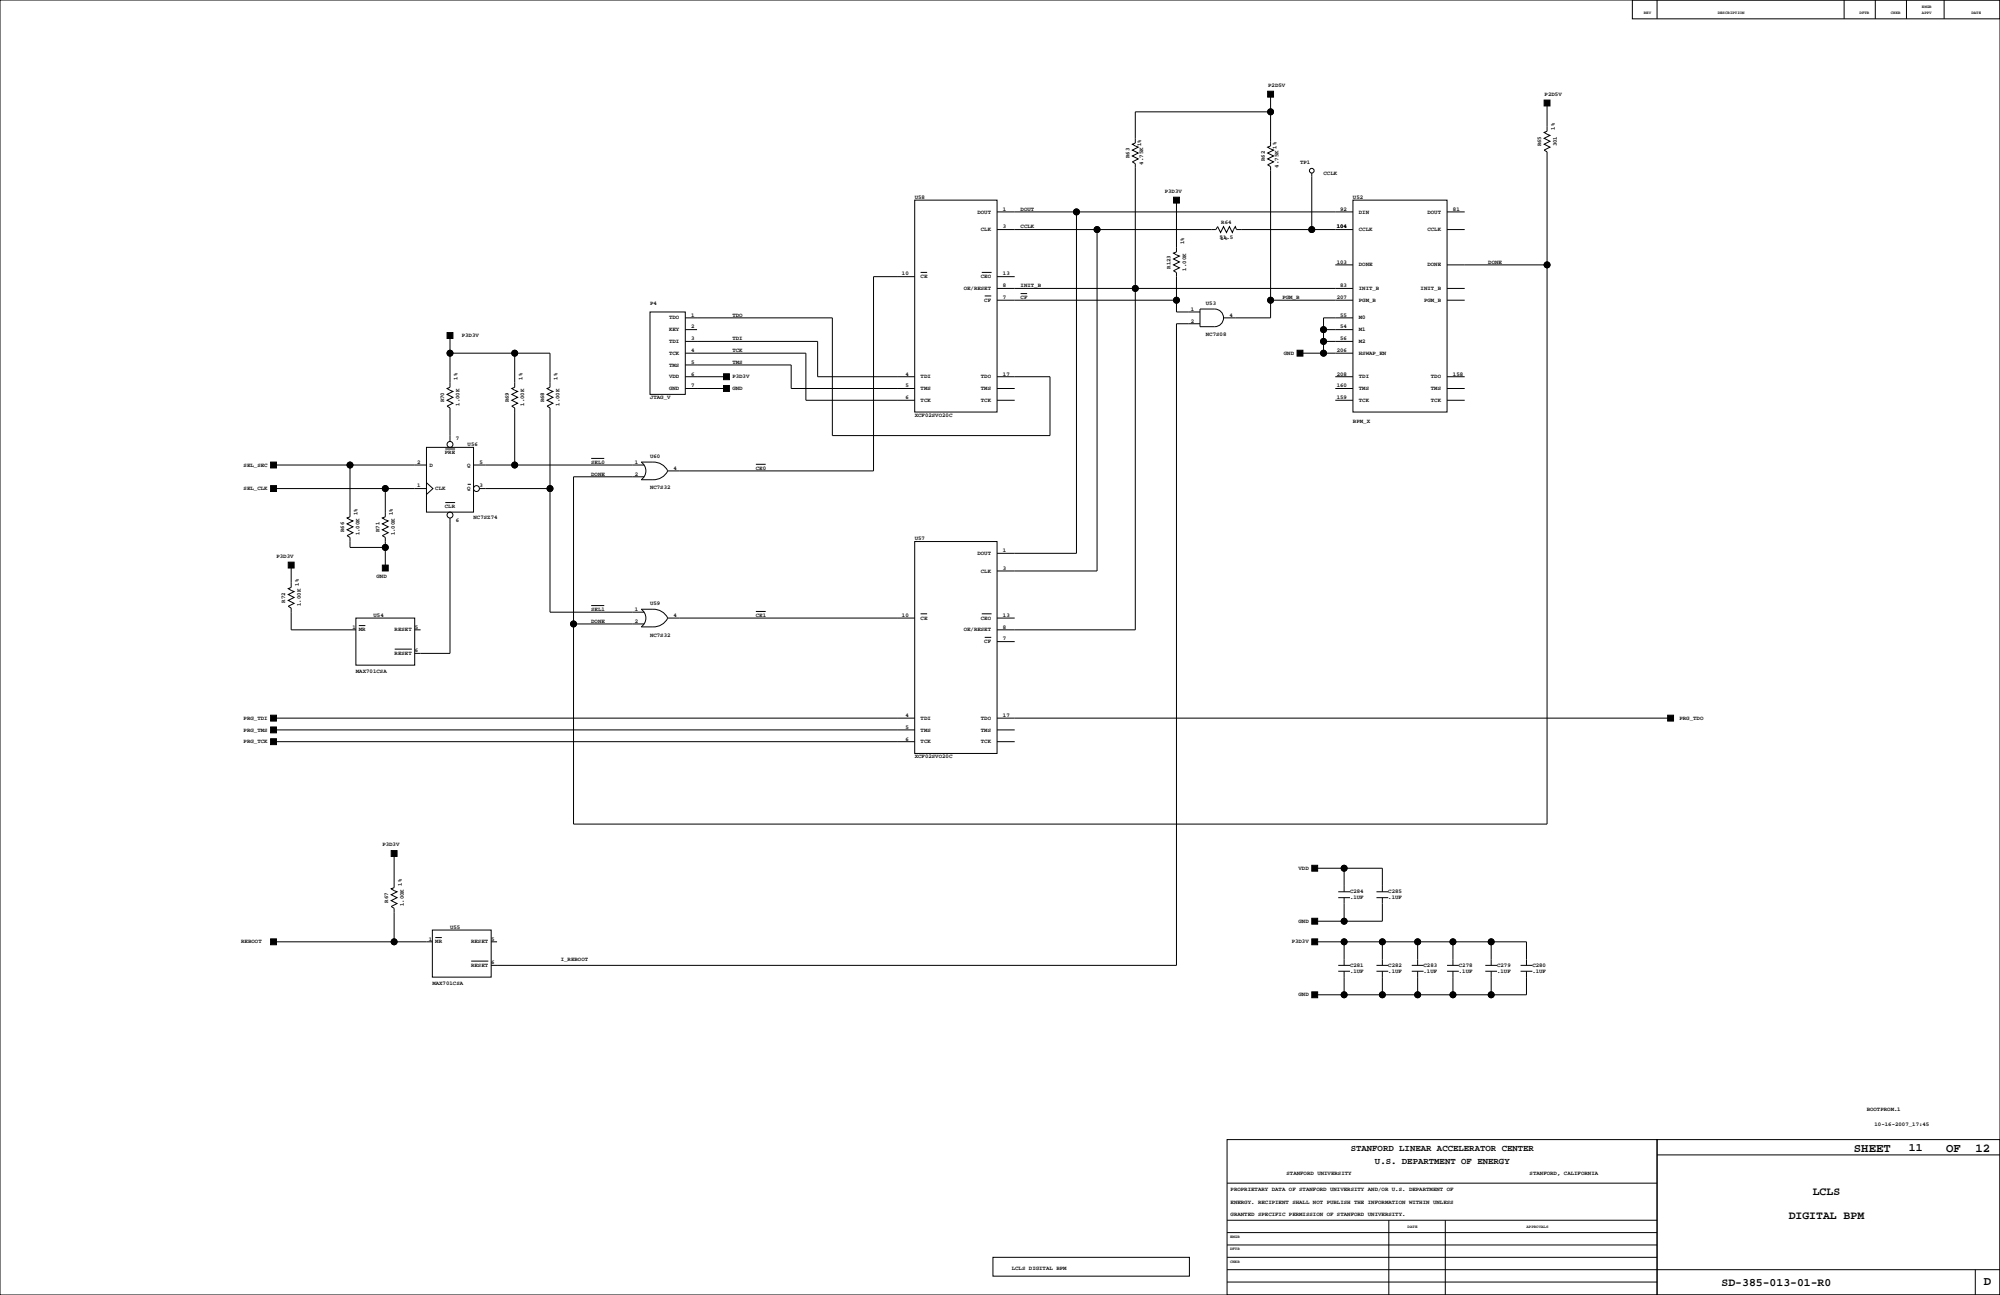
[picture p17: page 11]

STANFORD LINEAR ACCELERATOR CENTER
U.S. DEPARTMENT OF ENERGY

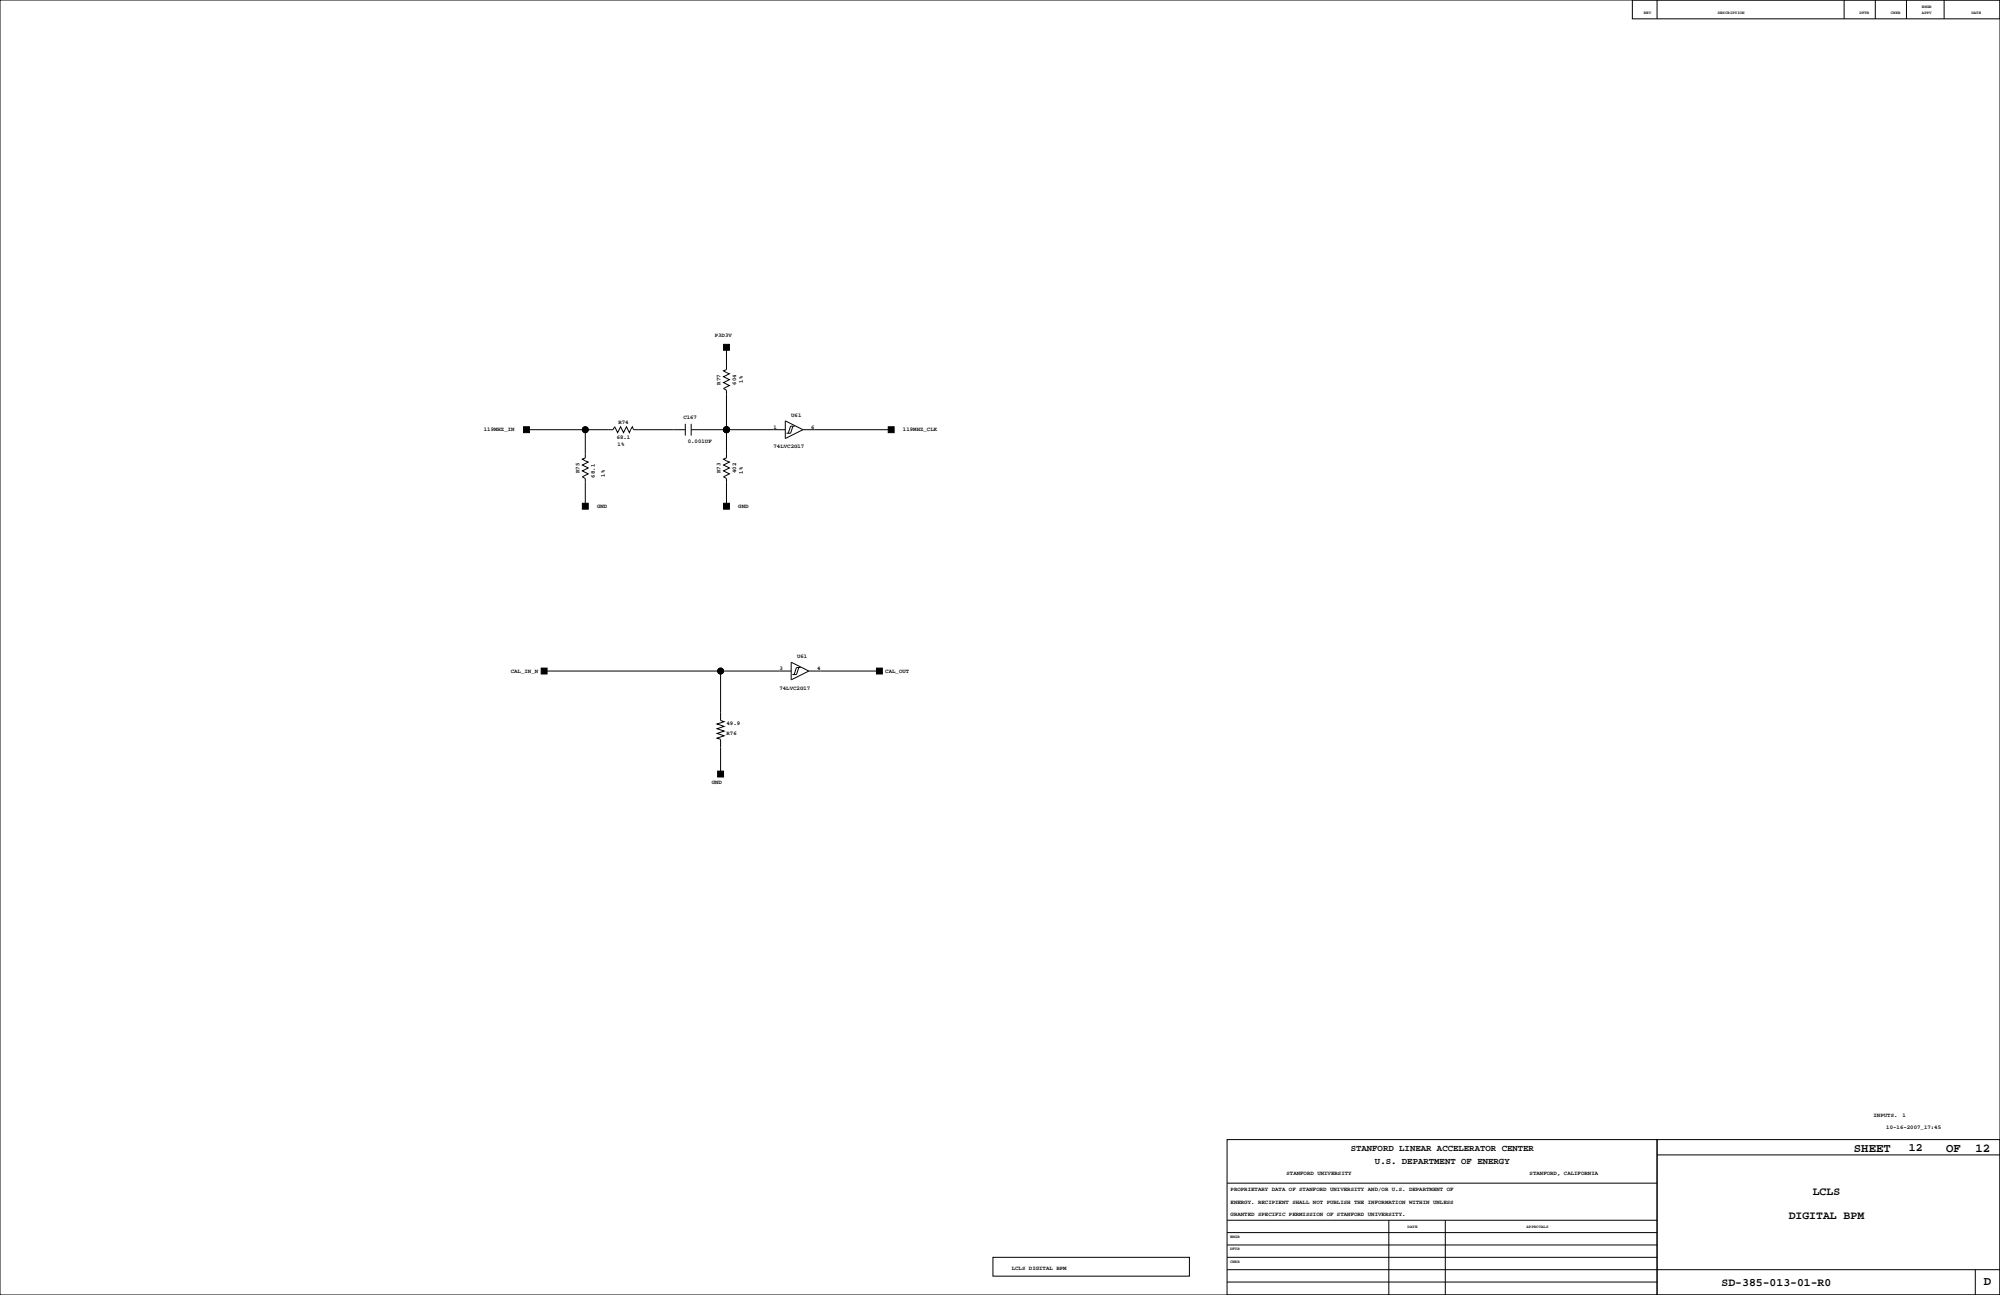
[picture p18: page 12]
SHEET; STANFORD UNIVERSITY; STANFORD, CALIFORNIA; 74LVC2G17; INPUTS; GND; CAL_IN_N; CAL_OUT; 119MHZ_IN; 119MHZ_CLK

STANFORD LINEAR ACCELERATOR CENTER
U.S. DEPARTMENT OF ENERGY

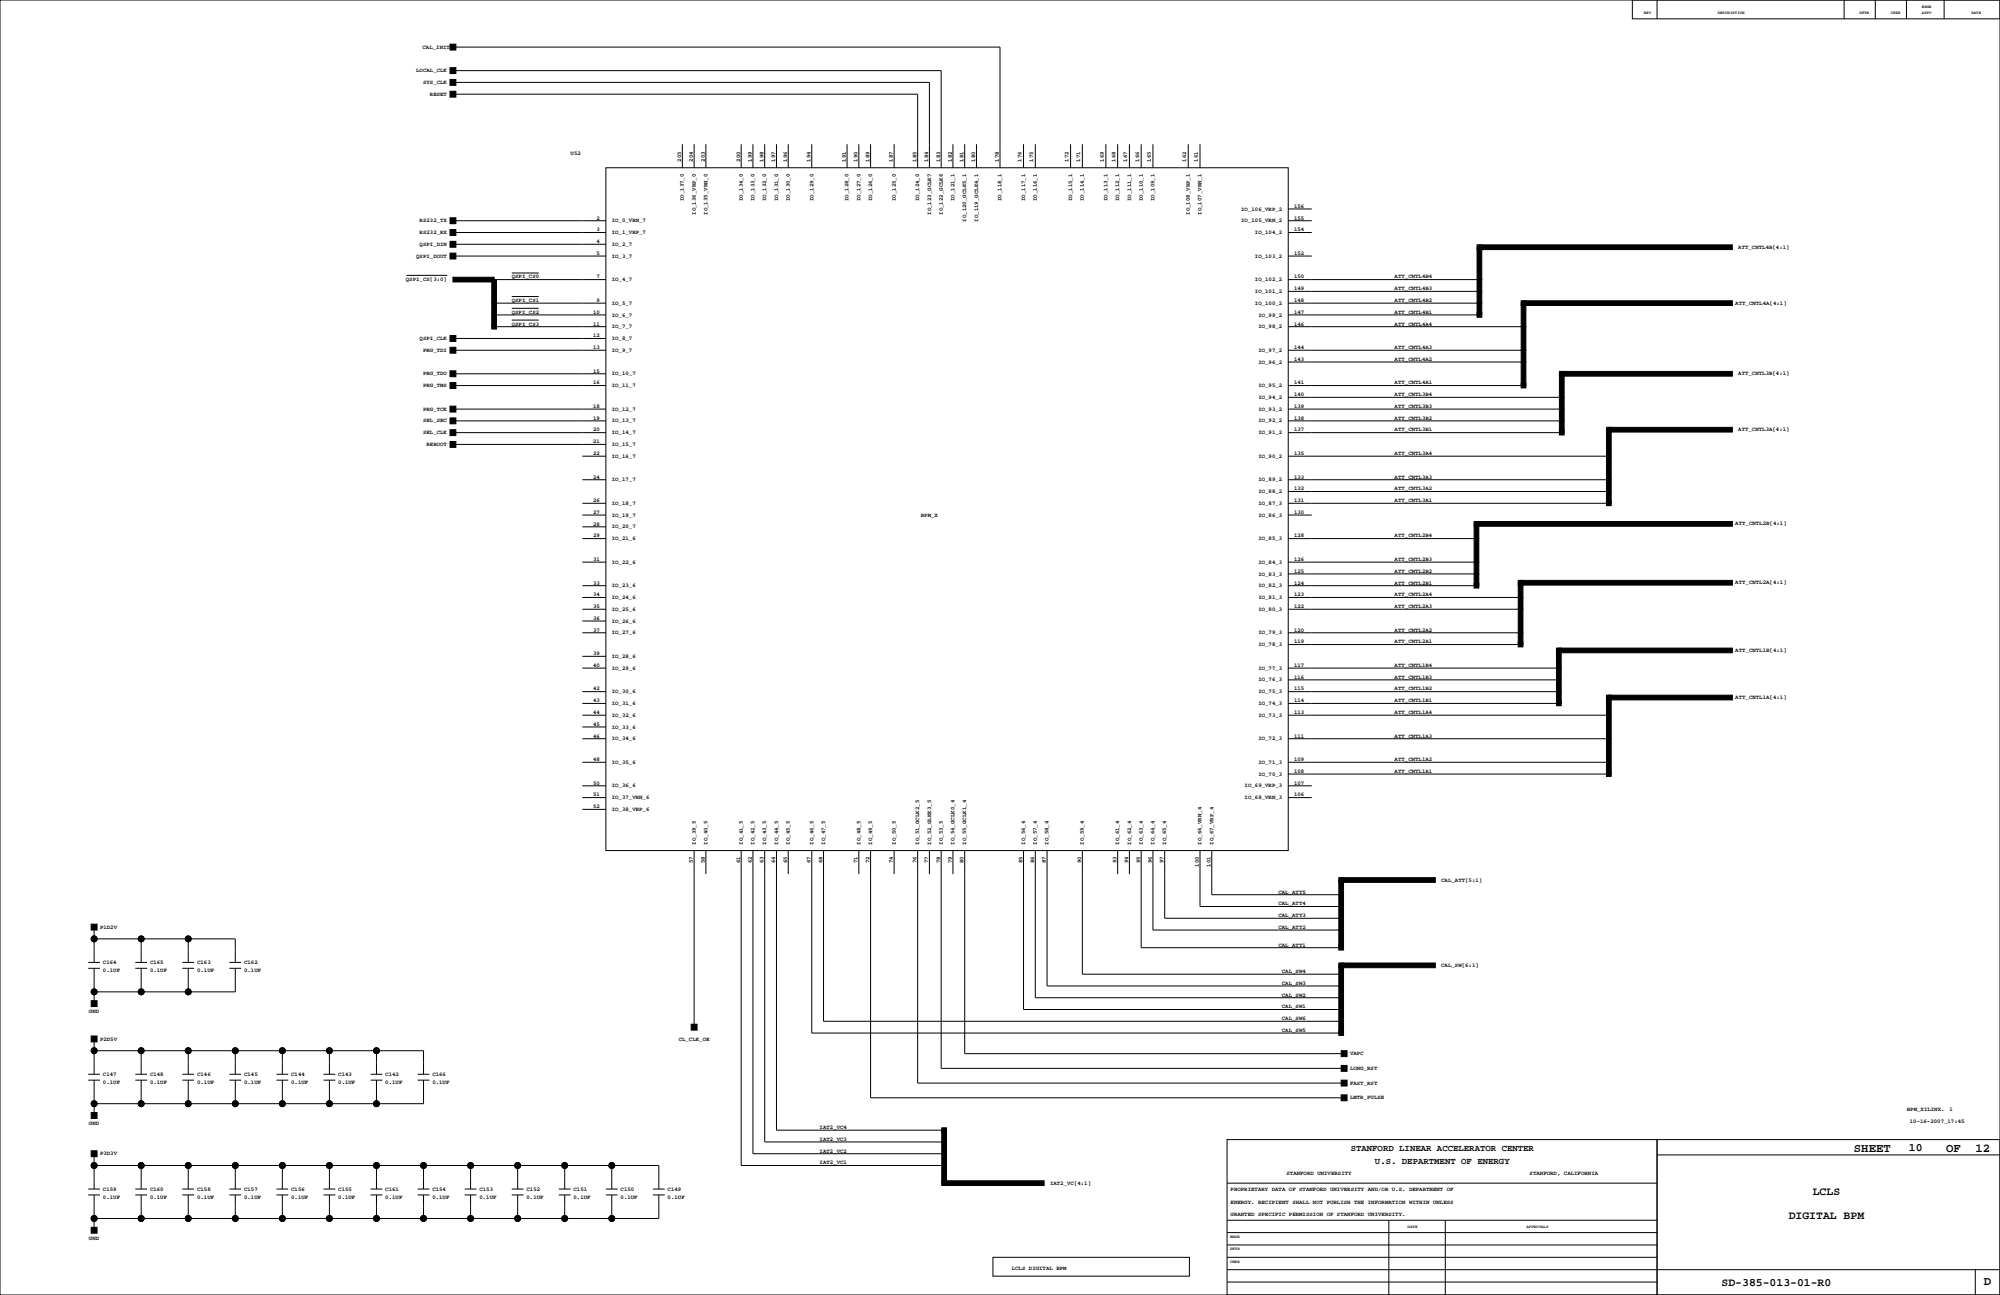
[picture p19: page 13]

STANFORD LINEAR ACCELERATOR CENTER
U.S. DEPARTMENT OF ENERGY
