JeffOlsen-SLAC/LG_Pizza_BPM/xilinx/vhdlV30/coregen/ClkDiv3/clkdiv3.vhd

--------------------------------------------------------------------------------
-- Copyright (c) 1995-2006 Xilinx, Inc.  All rights reserved.
--------------------------------------------------------------------------------
--   ____  ____ 
--  /   /\/   / 
-- /___/  \  /    Vendor: Xilinx 
-- \   \   \/     Version : 8.2.02i
--  \   \         Application : xaw2vhdl
--  /   /         Filename : clkdiv3.vhd
-- /___/   /\     Timestamp : 10/30/2006 10:15:41
-- \   \  /  \ 
--  \___\/\___\ 
--
--Command: xaw2vhdl-st F:\LCLS\BPM_digital\vhdl\coregen\ClkDiv3\\clkdiv3.xaw F:\LCLS\BPM_digital\vhdl\coregen\ClkDiv3\\clkdiv3
--Design Name: clkdiv3
--Device: xc3s400-5pq208
--
-- Module clkdiv3
-- Generated by Xilinx Architecture Wizard
-- Written for synthesis tool: XST

library ieee;
use ieee.std_logic_1164.ALL;
use ieee.numeric_std.ALL;
library UNISIM;
use UNISIM.Vcomponents.ALL;

entity clkdiv3 is
   port ( CLKIN_IN   : in    std_logic; 
          RST_IN     : in    std_logic; 
          CLKDV_OUT  : out   std_logic; 
          CLK0_OUT   : out   std_logic; 
          LOCKED_OUT : out   std_logic);
end clkdiv3;

architecture BEHAVIORAL of clkdiv3 is
   signal CLKDV_BUF  : std_logic;
   signal CLKFB_IN   : std_logic;
   signal CLK0_BUF   : std_logic;
   signal GND1       : std_logic;
   component BUFG
      port ( I : in    std_logic; 
             O : out   std_logic);
   end component;
   
   component DCM
      generic( CLK_FEEDBACK : string :=  "1X";
               CLKDV_DIVIDE : real :=  2.0;
               CLKFX_DIVIDE : integer :=  1;
               CLKFX_MULTIPLY : integer :=  4;
               CLKIN_DIVIDE_BY_2 : boolean :=  FALSE;
               CLKIN_PERIOD : real :=  10.0;
               CLKOUT_PHASE_SHIFT : string :=  "NONE";
               DESKEW_ADJUST : string :=  "SYSTEM_SYNCHRONOUS";
               DFS_FREQUENCY_MODE : string :=  "LOW";
               DLL_FREQUENCY_MODE : string :=  "LOW";
               DUTY_CYCLE_CORRECTION : boolean :=  TRUE;
               FACTORY_JF : bit_vector :=  x"C080";
               PHASE_SHIFT : integer :=  0;
               STARTUP_WAIT : boolean :=  FALSE;
               DSS_MODE : string :=  "NONE");
      port ( CLKIN    : in    std_logic; 
             CLKFB    : in    std_logic; 
             RST      : in    std_logic; 
             PSEN     : in    std_logic; 
             PSINCDEC : in    std_logic; 
             PSCLK    : in    std_logic; 
             DSSEN    : in    std_logic; 
             CLK0     : out   std_logic; 
             CLK90    : out   std_logic; 
             CLK180   : out   std_logic; 
             CLK270   : out   std_logic; 
             CLKDV    : out   std_logic; 
             CLK2X    : out   std_logic; 
             CLK2X180 : out   std_logic; 
             CLKFX    : out   std_logic; 
             CLKFX180 : out   std_logic; 
             STATUS   : out   std_logic_vector (7 downto 0); 
             LOCKED   : out   std_logic; 
             PSDONE   : out   std_logic);
   end component;
   
begin
   GND1 <= '0';
   CLK0_OUT <= CLKFB_IN;
   CLKDV_BUFG_INST : BUFG
      port map (I=>CLKDV_BUF,
                O=>CLKDV_OUT);
   
   CLK0_BUFG_INST : BUFG
      port map (I=>CLK0_BUF,
                O=>CLKFB_IN);
   
   DCM_INST : DCM
   generic map( CLK_FEEDBACK => "1X",
            CLKDV_DIVIDE => 3.0,
            CLKFX_DIVIDE => 1,
            CLKFX_MULTIPLY => 4,
            CLKIN_DIVIDE_BY_2 => FALSE,
            CLKIN_PERIOD => 16.6667,
            CLKOUT_PHASE_SHIFT => "NONE",
            DESKEW_ADJUST => "SYSTEM_SYNCHRONOUS",
            DFS_FREQUENCY_MODE => "LOW",
            DLL_FREQUENCY_MODE => "LOW",
            DUTY_CYCLE_CORRECTION => TRUE,
            FACTORY_JF => x"8080",
            PHASE_SHIFT => 0,
            STARTUP_WAIT => FALSE)
      port map (CLKFB=>CLKFB_IN,
                CLKIN=>CLKIN_IN,
                DSSEN=>GND1,
                PSCLK=>GND1,
                PSEN=>GND1,
                PSINCDEC=>GND1,
                RST=>RST_IN,
                CLKDV=>CLKDV_BUF,
                CLKFX=>open,
                CLKFX180=>open,
                CLK0=>CLK0_BUF,
                CLK2X=>open,
                CLK2X180=>open,
                CLK90=>open,
                CLK180=>open,
                CLK270=>open,
                LOCKED=>LOCKED_OUT,
                PSDONE=>open,
                STATUS=>open);
   
end BEHAVIORAL;
