JeffOlsen-SLAC/LG_Pizza_BPM/xilinx/vhdlV30/qspi.vhd

-----------------------------------------------------------------
--                                                             --
-----------------------------------------------------------------
--
--      qspi.vhd - 
--
--      Copyright(c) SLAC 2000
--
--      Author: Jeff Olsen
--      Created on: 10/24/2006 12:23:13 PM
--      Last change: JO 10/26/2006 4:15:31 PM
--
-----------------------------------------------------------------
--                                                             --
-----------------------------------------------------------------
--
--      qspi.vhd - 
--
--      Copyright(c) Stanford Linear Accelerator Center 2000
--
--      Author: Jeff Olsen
--      Created on: 08/03/06

--
-- 
-- Created by Jeff Olsen 08/23/05
--
--  Filename: qspi.vhd
--
--  Function:
--  Implement QSPI protocol for BPM
--
--  Modifications:



--Library work;
--use work.pac.all;

library ieee;
use ieee.std_logic_1164.all;
use ieee.std_logic_unsigned.all;

entity qspi is
  port (
    Clock      : in  std_logic;
    Reset      : in  std_logic;
-- External interface
    Din        : in  std_logic;
    Dout       : out std_logic;
    Cs         : in  std_logic;
--
    Write_Strb : out std_logic;
    DataOut    : out std_logic_vector(7 downto 0);
    Address    : out std_logic_vector(7 downto 0);
    En         : out std_logic;
    DataIn     : in  std_logic_vector(7 downto 0)
    );
end qspi;

architecture Behaviour of qspi is

  type QSPI_State_t is
    (
      Idle,
      CMDIn,
      Readt,
      Read1,
      Writet
      );

  signal QSPI_State : QSPI_State_t;

  signal CMDSR     : std_logic_vector(7 downto 0);
  signal DataOutSR : std_logic_vector(7 downto 0);
  signal DataInSr  : std_logic_vector(7 downto 0);
  signal Counter   : std_logic_vector(3 downto 0);
  signal iRead     : std_logic;
  signal DoutEn    : std_logic;
  signal iDoutEn   : std_logic;
  signal Load      : std_logic;
  signal iDout     : std_logic;

begin

  Douten_p : process(Clock)
  begin
    if (Clock'event and Clock = '0') then
      iDoutEn <= DoutEn;
    end if;
  end process;

  Dout_p : process(Din, iDouten, iDout)
  begin
    if(iDoutEn = '0') then
      Dout <= Din;
    else
      Dout <= iDout;
    end if;
  end process;

  iDout_p : process(clock, reset)
  begin
    if (Reset = '1') then
      iDout <= '0';
    elsif (Clock'event and Clock = '0') then
      if (Load = '1') then
        iDout <= DataIn(7);
      else
        iDout <= DataOutSR(7);
      end if;
    end if;
  end process;  -- Dout_p


-- 8/14/20
-- Every now and then the SPI interface hangs
-- Added not CS to reset
--

  QSPI : process(Reset, Clock)
  begin
    if ((Reset = '1') or (CS = '0'))then
      Counter    <= (others => '0');
      CmdSr      <= (others => '0');
      DataOutSr  <= (others => '0');
      DataInSr   <= (others => '0');
      Write_Strb <= '0';
      En         <= '0';
      DoutEn     <= '0';
      iRead      <= '0';
      Load       <= '0';
    elsif (Clock'event and Clock = '1') then
      case QSPI_State is
        when Idle =>
          DoutEn     <= '0';
          Load       <= '0';
          Write_Strb <= '0';
          if (CS = '1') then
            EN                <= '1';
            CmdSR(7 downto 0) <= CmdSR(6 downto 0) & DIn;
            Counter           <= x"6";
            QSPI_State        <= CMDIn;
          else
            En         <= '0';
            iRead      <= '0';
            QSPI_State <= Idle;
          end if;

        when CMDIn =>
          Write_Strb        <= '0';
          CmdSR(7 downto 0) <= CmdSR(6 downto 0) & DIn;

          if (Counter = x"0") then
            Address    <= CmdSr(6 downto 0) & Din;
            Counter    <= x"7";
            QSPI_State <= Read1;
            Load       <= '1';
            DoutEn     <= '1';
            if (CmdSR(5) = '1') then
              iRead <= '1';
            else
              iRead <= '0';
            end if;
          else
            Counter    <= Counter -1;
            QSPI_State <= CMDIn;
          end if;

        when Read1 =>
          DataInSr              <= DataInSr(6 downto 0) & Din;
          Counter               <= Counter -1;
          Write_Strb            <= '0';
          Counter               <= Counter -1;
          Load                  <= '0';
          QSPI_State            <= Readt;
          DataOutSR(7 downto 0) <= DataIn(6 downto 0) & '0';


        when Readt =>
          DataInSr              <= DataInSr(6 downto 0) & Din;
          DataOutSR(7 downto 0) <= DataOutSR(6 downto 0) & '0';
          Counter               <= Counter -1;
          Load                  <= '0';
          if (Counter = x"0") then
            DataOut <= DataInSR(6 downto 0) & Din;
            if (iRead = '0') then
              Write_Strb <= '1';
            end if;
            DoutEn <= '0';

            QSPI_State <= Idle;
          else
            QSPI_State <= Readt;
          end if;

        when others =>
          En         <= '0';
          Write_Strb <= '0';
          QSPI_State <= Idle;

      end case;
    end if;
  end process;  --QSPI

end Behaviour;
